blackketter/oc1/README

This directory contains the hardware design and support documents for the OpenCalc OC1 calculator.
