blackketter/oc1/pa1/docs/display/all-shore/ASIJ24016HFDCIDI.PDF

## Outline Drawing

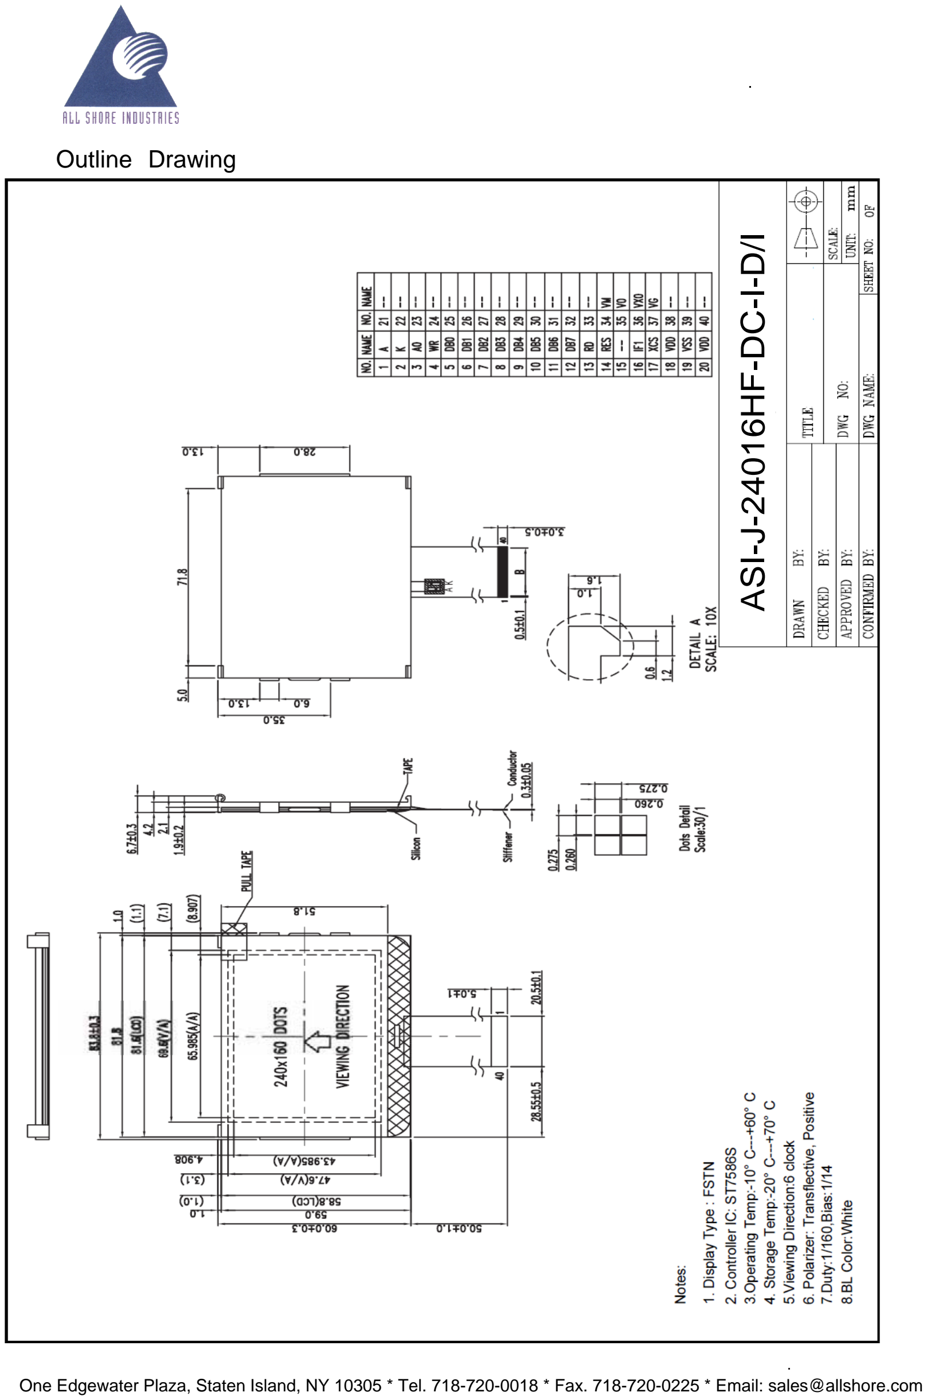
[picture p3: page 1]

One Edgewater Plaza, Staten Island, NY 10305 * Tel. 718-720-0018 * Fax. 718-720-0225 * Email: sales@allshore.com ASI-J⁻24016HF⁻DC⁻I-D/I
