blackketter/oc1/pa1/docs/display/all-shore/allshore-external-connections.jpg

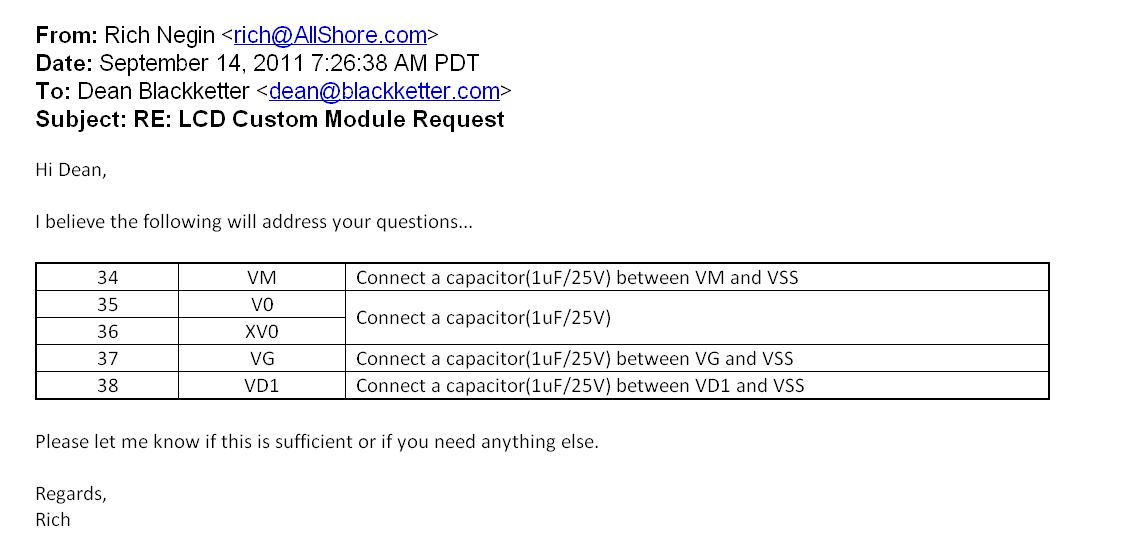
pa1/docs/display/all-shore/allshore-external-connections.jpg
