blackketter/oc1/datasheets/cpu/IMX23_POWER_CONSUMP_CALC.xls

Sheet: POWER CONSUMPTION CALCULATOR
 |  | i.MX23 Power Consumption Calculator
Disclaimer: The power consumption calculator is intended to provide an estimation of typical system power under different CPU clock frequencies and device configurations. The core power measurements were taken using 100% CPU load with the iMX23 power savings features disabled (i.e., INTERRUPT WAIT and HBUS AUTOSLOW). Actual measured power results may vary based on the actual application CPU loading.
INSTRUCTIONS
Enter configuration options into yellow cells. Select "INCLUDE" or "EXCLUDE" to include/exclude each power in the summary. |  |  |  |  |  | LEGEND | User Configurable Cells
Note that some power is Internal (on-chip) and some is External (off-chip) - consult legend to the right for color-coding. |  |  |  |  |  |  | Internal (On-chip) Power
The number in parenthesis following the power (e.g., (1) or (8)) corresponds to the system diagram (scroll to the bottom to see diagram). |  |  |  |  |  |  | External (Off-chip) Power
ARM CORE & DRAM | CONFIGURATION |  | VALUE | UNITS | COMMENTS
 | DRAM Type |  | DDR1 |  |  |  |  | Package | ThetaJA |  |  | Power Source | Speaker Impedance | Max. Pd |  |  |  | Temperature | Max. Tj |  | DRAM
 | CPU CLK / AHB CLK / EMI CLK Frequencies |  | 64.00 / 64.00 / 48.00 | MHz |  |  |  | 169BGA | 42 |  | EXCLUDE | VDD5V | 4 | 0 | Pink Noise |  |  | Industrial | 105 |  | DDR1
 | INCLUDE | i.MX23 ARM Core Power (4) | 34.75 | mW | On-chip power into iMX23 VDDD input with INTERRUPT WAIT and HBUS AUTOSLOW disabled. |  |  | 128QFP | 43 |  | INCLUDE | Li-Ion Battery | 8 | 1 | 1kHz 0dB Sine Wave |  |  | Commercial | 85 |  | mDDR
 | INCLUDE | i.MX23 DRAM Controller Power (2) | 9.925 | mW | On-chip power into iMX23 DDR1 Controller VDDIO_EMI input |  |  |  |  |  |  |  |  | 0.8
 | EXCLUDE | External DRAM Power (9) | 0.00 | mW | Off-chip power from VDDM supply into DDR1 DRAM |  |  | DDRLIST | 34.43 | 4.89 | 21.10 |  |  |  |  |  | 34.7516 | 9.9255 | 77.6225
HEADPHONE AMP | CONFIGURATION |  | VALUE | UNITS | COMMENTS |  |  | mDDR | PDDD | PDDA | PDDR1 | CPUCLK | HCLK | EMICLK | MENU | DDR1 | PDDD | PDDM | PDDR1 | CPUCLK | HCLK | EMICLK | MENU
 | Headphone Load |  | 32 | Ω |  |  |  |  | 16.10 | 0.89 | 5.32 | 24.00 | 24.00 | 24.00 | 24.00 / 24.00 / 24.00 |  | 34.75 | 9.93 | 77.62 | 64.00 | 64.00 | 48.00 | 64.00 / 64.00 / 48.00
 | Headphone Mode |  | Direct Drive |  |  |  |  |  | 34.43 | 4.89 | 21.10 | 64.00 | 64.00 | 48.00 | 64.00 / 64.00 / 48.00 |  | 125.26 | 18.83 | 75.84 | 261.82 | 130.91 | 130.91 | 261.82 / 130.91 / 130.91
 | File Type |  | Pink Noise |  | "Pink Noise" approximates real music. "1kHz 0dB Sine Wave" is likely worst-case. |  |  |  | 124.58 | 9.58 | 28.03 | 261.82 | 130.91 | 130.91 | 261.82 / 130.91 / 130.91 |  | 169.72 | 20.14 | 82.88 | 360.00 | 120.00 | 120.00 | 360.00 / 120.00 / 120.00
 | Output Amplitude |  | 0.113 | Vavg |  |  |  |  | 168.52 | 10.65 | 31.42 | 360.00 | 120.00 | 120.00 | 360.00 / 120.00 / 120.00 |  | 205.95 | 21.93 | 83.89 | 392.73 | 130.91 | 130.91 | 392.73 / 130.91 / 130.91
 | EXCLUDE | i.MX23 Headphone Amplifier Power (3) | 0.00 | mW | On-chip power into i.MX23 VDDA input due to headphone amp. Includes power into headphone load. |  |  |  | 205.06 | 11.18 | 31.95 | 392.73 | 130.91 | 130.91 | 392.73 / 130.91 / 130.91 |  | 272.71 | 24.73 | 91.29 | 454.74 | 151.58 | 151.58 | 454.74 / 151.58 / 151.58
SPEAKER AMP | CONFIGURATION |  | VALUE | UNITS | COMMENTS |  |  |  | 272.92 | 12.57 | 33.744 | 454.74 | 151.58 | 151.58 | 454.74 / 151.58 / 151.58
 | Speaker Impedance |  | 8 | Ω |  |  |  |  | Select Valid Frequency
 | File Type |  | 1kHz 0dB Sine Wave |  | "Pink Noise" approximates real music. "1kHz 0dB Sine Wave" is likely worst-case.
 | Output Amplitude |  | 1.210 | Vrms
 | EXCLUDE | i.MX23 Speaker Amplifier Power (5) | 0.00 | mW | On-chip power into i.MX23 VDDS input due to speaker amp. Includes power into speaker load. |  |  | Mode | File | Load | AC321K | AC161K | AC32P | AC16P | D321K | D161K | D32P | D16P |  | S41K | S81K | S4P | S8P
DAC | CONFIGURATION |  | VALUE | UNITS | COMMENTS |  |  | AC-Coupled | Pink Noise | 16 | 0.594 | 0.566 | 0.255 | 0.236 | 0.608 | 0.566 | 0.294 | 0.288 |  | 2.700 | 3.200 | 1.300 | 1.390
 | EXCLUDE | i.MX23 DAC Power (3) | 0.00 | mW | On-chip power into i.MX23 VDDA input due to DAC. Should be included if Headphone or Speaker are on. |  |  | Direct Drive | 1kHz 0dB Sine Wave | 32 | 0.523 | 0.509 | 0.161 | 0.186 | 0.587 | 0.516 | 0.210 | 0.230 |  | 2.580 | 2.630 | 1.250 | 1.060
SD/MMC CARD | CONFIGURATION |  | VALUE | UNITS | COMMENTS |  |  |  |  |  | 0.410 | 0.452 | 0.113 | 0.133 | 0.467 | 0.460 | 0.150 | 0.205 |  | 2.300 | 2.540 | 1.060 | 0.888
 | EXCLUDE | External SD/MMC Card Power (7) | 0.00 | mW | Off-chip power from VDDIO supply into SD/MMC card. Enter power from SD/MMC card datasheet. |  |  |  |  |  | 0.325 | 0.410 | 0.077 | 0.105 | 0.353 | 0.339 | 0.099 | 0.166 |  | 2.050 | 2.160 | 0.660 | 0.560
LCD | CONFIGURATION |  | VALUE | UNITS | COMMENTS |  |  | HP Power | HPList |  | 0.255 | 0.339 | 0.032 | 0.064 | 0.247 | 0.283 | 0.070 | 0.118 |  | 1.830 | 1.710 | 0.533 | 0.350
 | EXCLUDE | i.MX23 LCD Controller Power (1) | 0.00 | mW | On-chip power into i.MX23 VDDIO input due to LCD controller. |  |  | #N/A | D32P |  | 0.205 | 0.283 | 0.018 | 0.040 | 0.212 | 0.233 | 0.050 | 0.077 |  | 1.540 | 1.530 | 0.333 | 0.231
 | EXCLUDE | External LCD Digital Power (6) | 0.00 | mW | Off-chip power from VDDIO supply into LCD module . Enter power from LCD datasheet. |  |  |  | Pick Output Amplitude |  | 0.141 | 0.226 |  | 0.010 | 0.166 | 0.177 | 0.026 | 0.032 |  | 1.300 | 1.210 | 0.225 | 0.089
 | EXCLUDE | External LCD Backlight Power (10) | 0.00 | mW | Off-chip power from Li-Battery supply into LCD backlight. Enter power from LCD datasheet. |  |  |  |  |  | 0.106 | 0.170 |  |  | 0.127 | 0.113 |  |  |  | 1.160 | 1.020 | 0.093 | 0.038
NAND FLASH | CONFIGURATION |  | VALUE | UNITS | COMMENTS |  |  |  |  |  | 0.071 | 0.113 |  |  | 0.071 | 0.078 |  |  |  | 1.030 | 0.811
 | EXCLUDE | External NAND Flash Power (8) | 0.00 | mW | Off-chip power from VDDIO supply into NAND flash. Enter power from NAND datasheet. |  |  |  |  |  | 0.025 | 0.078 |  |  | 0.055 | 0.062 |  |  |  | 0.615 | 0.644
 |  |  |  |  |  |  |  |  |  |  |  | 0.028 |  |  | 0.036 | 0.028 |  |  |  | 0.461 | 0.512
RESULTS |  |  |  |  |  |  |  | SP Power | SPList |  |  |  |  |  |  |  |  |  |  | 0.260 | 0.322
 |  |  |  |  |  |  |  | 579.6 | S81K |  |  |  |  |  |  |  |  |  |  | 0.207 | 0.171
SUMMARY OF POWER BY SUPPLY RAIL | POWER BY RAIL SUMMARY |  | VALUE | UNITS | COMMENTS |  |  |  |  |  |  |  |  |  |  |  |  |  |  | 0.118 | 0.129
 | VDDD Power | Internal | 34.752 | mW | Includes: ARM core |  |  |  |  |  |  |  |  |  |  |  |  |  |  | 0.068 | 0.066
 |  | External | 0.000 | mW |  |  |  |  |  |  |  |  |  |  |  |  |  |  |  | 0.032 | 0.017
 |  | Total (13) | 34.752 | mW
 | VDDIO Power | Internal | 0.000 | mW | Includes: LCD controller, NAND flash controller, SD/MMC controller
 |  | External | 0.000 | mW | Includes: LCD, NAND flash, SD/MMC card
 |  | VDDM Linear Regulator Power | 3.176 | mW | Power dissipated in internal VDDM linear regulator powered from VDDIO. Mostly external.
 |  | Total (15) | 3.176 | mW
 | VDDA Power | Internal | 0.000 | mW | Includes: headphone amp, DAC, mDDR Controller
 |  | External | 0.000 | mW | Includes: mDDR DRAM device |  |  |  |  |  |  |  |  |  |  | EFFICIENCY
 |  | Total (14) | 0.000 | mW |  |  |  |  |  |  |  |  |  |  |  | Vin (V)
 | VDDM Power | Internal | 9.925 | mW | Includes: DDR1 controller |  |  |  | Spreadsheet Value | Approximation |  |  |  |  | LABEL | PDDD | PDDIO | PDDA | DCDC Settings | 4.2 | 4 | 3.8 | 3.6 | 3.4
 |  | External | 0.000 | mW | Includes: DDR1 DRAM device |  |  | PDDD | 34.7516 | 53 |  |  |  |  | 5315688 | 53 | 156 | 88 | Normal Fets | 0.9155 | 0.9176 | 0.9140 | 0.9155 | 0.9179
 |  | Total (16) | 9.925 | mW |  |  |  | PDDA | 0 | 88 |  |  |  |  | 53630350 | 53 | 630 | 350 | Normal Fets | 0.7479 | 0.7392 | 0.7205 | 0.6969 | 0.6575
 | Li-Ion Battery Power | Internal | 0.000 | mW | Includes: speaker amp |  |  | PDDIO + PDDM | 13.10166 | 156 |  |  |  |  | 5363088 | 53 | 630 | 88 | Normal Fets | 0.8488 | 0.8446 | 0.8415 | 0.8253 | 0.8026
 |  | External | 0.000 | mW | Includes: LCD backlight boost converter |  |  |  |  |  |  |  |  |  | 53156350 | 53 | 156 | 350 | Normal Fets | 0.7909 | 0.7955 | 0.7876 | 0.7885 | 0.7731
 |  | Total (10) + (5) | 0.000 | mW |  |  |  | LABEL | 5315688 |  |  |  |  |  | 12815688 | 128 | 156 | 88 | Normal Fets | 0.8626 | 0.8663 | 0.8667 | 0.8648 | 0.8618
TOTAL POWER CONSUMPTION ESTIMATE SUMMARY | TOTAL POWER SUMMARY |  | VALUE | UNITS | COMMENTS |  |  | MATCH | 1 |  |  |  |  |  | 128630350 | 128 | 630 | 350 | Normal Fets | 0.7297 | 0.7265 | 0.7028 | 0.6774 | 0.6419
 | Power Out of PMU | Internal | 44.677 | mW | On-chip power consumption estimate. Doesn't account for DCDC efficiency |  |  | INDEX | 0.9161064574 |  |  |  |  |  | 12863088 | 128 | 630 | 88 | Normal Fets | 0.8091 | 0.8053 | 0.8057 | 0.7866 | 0.7630
 |  | External | 3.176 | mW | Off-chip power consumption estimate. Doesn't account for DCDC efficiency |  |  |  |  |  |  |  |  |  | 128156350 | 128 | 156 | 350 | Normal Fets | 0.7743 | 0.7601 | 0.7612 | 0.7566 | 0.7691
 |  | Total (13) + (14) + (15) + (16) | 47.853 | mW | Total power consumption estimate. Doesn't account for DCDC efficiency |  |  |  |  |  |  |  |  |  | 23315688 | 233 | 156 | 88 | Double FETs | 0.8554 | 0.8554 | 0.8595 | 0.8520 | 0.8502
 | DCDC Efficiency |  | 91.61 | % | Estimate from DCDC Efficiency Curves |  |  |  |  |  |  |  |  |  | 233630350 | 233 | 630 | 350 | Double FETs | 0.7169 | 0.7064 | 0.7034 | 0.6807 | 0.6500
 | Battery Power Into PMU | Internal | 48.768 | mW | On-chip battery power consumption estimate, including DCDC efficiency |  |  |  |  |  |  |  |  |  | 23363088 | 233 | 630 | 88 | Double FETs | 0.8004 | 0.7934 | 0.7885 | 0.7813 | 0.7567
 |  | External | 3.467 | mW | Off-chip battery power consumption estimate, including DCDC efficiency |  |  |  |  |  |  |  |  |  | 233156350 | 233 | 156 | 350 | Double FETs | 0.7215 | 0.7183 | 0.7163 | 0.7112 | 0.7086
 |  | Total (11) | 52.235 | mW | Estimate of total battery power into PMU, including DCDC efficiency. Excludes battery power into non-PMU loads (e.g, speaker amp, LCD backlight).
 | Total Power Out Of Battery | Total (12) | 52.235 | mW | Estimate of total battery power consumption. Includes DCDC efficiency, speaker amp, and LCD backlight.

Sheet: Headphone Power
Headphone Mode | File Type | Headphone Load (Ω) | VDDA (V) | IddHP (mA) | Pin (mW) | Vout (Vrms) | Pout (mW) | Efficiency | DAC Power
Direct Drive | 1kHz 0dB Sine Wave | 16 | 1.85 | 70.0 | 126.75 | 0.566 | 39.99 | 31.55% | 2.7492
Direct Drive | 1kHz 0dB Sine Wave | 16 | 1.84 | 63.5 | 114.04 | 0.516 | 33.30 | 29.20% | Subtracted out from Pin
AC-Coupled | 1kHz 0dB Sine Wave | 16 | 1.81 | 39.7 | 69.11 | 0.566 | 39.99 | 57.86%
Direct Drive | 1kHz 0dB Sine Wave | 16 | 1.83 | 56.4 | 100.41 | 0.460 | 26.40 | 26.29%
AC-Coupled | 1kHz 0dB Sine Wave | 16 | 1.8 | 33.3 | 57.24 | 0.509 | 32.39 | 56.58%
AC-Coupled | 1kHz 0dB Sine Wave | 16 | 1.79 | 29.8 | 50.50 | 0.452 | 25.59 | 50.67%
Direct Drive | 1kHz 0dB Sine Wave | 16 | 1.8 | 43.5 | 75.50 | 0.339 | 14.40 | 19.07%
AC-Coupled | 1kHz 0dB Sine Wave | 16 | 1.79 | 27.0 | 45.58 | 0.410 | 21.02 | 46.11%
Direct Drive | 1kHz 0dB Sine Wave | 16 | 1.79 | 35.1 | 60.10 | 0.283 | 10.00 | 16.63%
AC-Coupled | 1kHz 0dB Sine Wave | 16 | 1.78 | 23.2 | 38.55 | 0.339 | 14.40 | 37.35%
Direct Drive | 1kHz 0dB Sine Wave | 16 | 1.78 | 28.4 | 47.80 | 0.233 | 6.80 | 14.23%
AC-Coupled | 1kHz 0dB Sine Wave | 16 | 1.77 | 19.0 | 30.88 | 0.283 | 10.00 | 32.37%
Direct Drive | 1kHz 0dB Sine Wave | 16 | 1.77 | 21.0 | 34.42 | 0.177 | 3.91 | 11.35%
Direct Drive | 1kHz 0dB Sine Wave | 16 | 1.76 | 15.1 | 23.76 | 0.113 | 1.60 | 6.73%
AC-Coupled | 1kHz 0dB Sine Wave | 16 | 1.77 | 15.6 | 24.77 | 0.226 | 6.40 | 25.83%
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
AC-Coupled | 1kHz 0dB Sine Wave | 32 | 1.74 | 3.0 | 2.47 | 0.025 | 0.04 | 1.64%
Direct Drive | Pink Noise | 32 | 1.74 | 4.5 | 5.08 | 0.026 | 0.04 | 0.83%
AC-Coupled | Pink Noise | 32 | 1.74 | 3.2 | 2.84 | 0.018 | 0.02 | 0.71%

Sheet: Speaker Power
File Type | Speaker Load (Ω) | VDDS | IDDS (mA) | Pin (mW) | Vout (Vrms) | Pout (mW) | Efficiency | Pdiss On chip (mW)
1kHz 0dB Sine Wave | 4 | 4.2 | 659 | 2767.8 | 2.700 | 1638.20 | 59.19% | 1129.6
1kHz 0dB Sine Wave | 4 | 4.2 | 608 | 2553.6 | 2.580 | 1495.82 | 58.58% | 1057.8
1kHz 0dB Sine Wave | 4 | 4.2 | 523 | 2196.6 | 2.300 | 1188.76 | 54.12% | 1007.8
1kHz 0dB Sine Wave | 4 | 4.2 | 464 | 1948.8 | 2.050 | 944.38 | 48.46% | 1004.4
1kHz 0dB Sine Wave | 4 | 4.2 | 414 | 1738.8 | 1.830 | 752.56 | 43.28% | 986.2
1kHz 0dB Sine Wave | 4 | 4.2 | 348 | 1461.6 | 1.540 | 532.94 | 36.46% | 928.7
1kHz 0dB Sine Wave | 4 | 4.2 | 293 | 1230.6 | 1.300 | 379.78 | 30.86% | 850.8
1kHz 0dB Sine Wave | 4 | 4.2 | 261 | 1096.2 | 1.160 | 302.38 | 27.58% | 793.8
Pink Noise | 4 | 4.2 | 202 | 848.4 | 0.660 | 96.80 | 11.41% | 751.6
1kHz 0dB Sine Wave | 4 | 4.2 | 233 | 978.6 | 1.030 | 238.40 | 24.36% | 740.2
Pink Noise | 4 | 4.2 | 265 | 1113 | 1.300 | 375.56 | 33.74% | 737.4
Pink Noise | 4 | 4.2 | 247 | 1037.4 | 1.250 | 347.22 | 33.47% | 690.2
Pink Noise | 4 | 4.2 | 212 | 890.4 | 1.060 | 249.69 | 28.04% | 640.7
1kHz 0dB Sine Wave | 4 | 4.2 | 139 | 583.8 | 0.615 | 84.99 | 14.56% | 498.8
1kHz 0dB Sine Wave | 8 | 4.2 | 195 | 819.0 | 1.710 | 365.51 | 44.63% | 453.5
1kHz 0dB Sine Wave | 8 | 4.2 | 245 | 1029.0 | 2.160 | 583.20 | 56.68% | 445.8
1kHz 0dB Sine Wave | 8 | 4.2 | 174 | 730.8 | 1.530 | 292.61 | 40.04% | 438.2
1kHz 0dB Sine Wave | 8 | 4.2 | 288 | 1209.6 | 2.540 | 806.45 | 66.67% | 403.2
1kHz 0dB Sine Wave | 8 | 4.2 | 138 | 579.6 | 1.210 | 183.01 | 31.58% | 396.6
1kHz 0dB Sine Wave | 8 | 4.2 | 300 | 1260.0 | 2.630 | 864.61 | 68.62% | 395.4
1kHz 0dB Sine Wave | 4 | 4.2 | 104 | 436.8 | 0.461 | 47.76 | 10.93% | 389.0
Pink Noise | 4 | 4.2 | 106 | 445.2 | 0.533 | 63.13 | 14.18% | 382.1
1kHz 0dB Sine Wave | 8 | 4.2 | 116 | 487.2 | 1.020 | 130.05 | 26.69% | 357.2
Pink Noise | 8 | 4.2 | 140 | 588.0 | 1.390 | 241.51 | 41.07% | 346.5
Pink Noise | 8 | 4.2 | 115 | 483.0 | 1.060 | 140.45 | 29.08% | 342.5
1kHz 0dB Sine Wave | 8 | 4.2 | 386 | 1621.2 | 3.200 | 1280.00 | 78.95% | 341.2
1kHz 0dB Sine Wave | 8 | 4.2 | 92 | 386.4 | 0.811 | 82.22 | 21.28% | 304.2
Pink Noise | 8 | 4.2 | 90 | 378.0 | 0.888 | 98.57 | 26.08% | 279.4
1kHz 0dB Sine Wave | 8 | 4.2 | 73 | 306.6 | 0.644 | 51.84 | 16.91% | 254.8
Pink Noise | 4 | 4.2 | 66 | 277.2 | 0.333 | 24.64 | 8.89% | 252.6
1kHz 0dB Sine Wave | 4 | 4.2 | 59 | 247.8 | 0.260 | 15.19 | 6.13% | 232.6
1kHz 0dB Sine Wave | 8 | 4.2 | 58 | 243.6 | 0.512 | 32.77 | 13.45% | 210.8
Pink Noise | 8 | 4.2 | 55 | 231.0 | 0.560 | 39.20 | 16.97% | 191.8
1kHz 0dB Sine Wave | 4 | 4.2 | 47 | 197.4 | 0.207 | 9.63 | 4.88% | 187.8
Pink Noise | 4 | 4.2 | 45 | 189 | 0.225 | 11.25 | 5.95% | 177.8
Pink Noise | 8 | 4.2 | 38 | 159.6 | 0.350 | 15.31 | 9.59% | 144.3
1kHz 0dB Sine Wave | 8 | 4.2 | 37 | 155.4 | 0.322 | 12.96 | 8.34% | 142.4
1kHz 0dB Sine Wave | 4 | 4.2 | 27 | 113.4 | 0.118 | 3.13 | 2.76% | 110.3
Pink Noise | 8 | 4.2 | 23 | 96.6 | 0.231 | 6.67 | 6.90% | 89.9
1kHz 0dB Sine Wave | 8 | 4.2 | 20 | 84.0 | 0.171 | 3.66 | 4.35% | 80.3
Pink Noise | 4 | 4.2 | 18.5 | 77.7 | 0.093 | 1.92 | 2.47% | 75.8
1kHz 0dB Sine Wave | 4 | 4.2 | 15 | 63 | 0.068 | 1.04 | 1.65% | 62.0
1kHz 0dB Sine Wave | 8 | 4.2 | 15 | 63.0 | 0.129 | 2.08 | 3.30% | 60.9
Pink Noise | 8 | 4.2 | 9 | 37.8 | 0.089 | 0.99 | 2.62% | 36.8
1kHz 0dB Sine Wave | 8 | 4.2 | 7.9 | 33.2 | 0.066 | 0.54 | 1.64% | 32.6
1kHz 0dB Sine Wave | 4 | 4.2 | 7 | 29.4 | 0.032 | 0.23 | 0.78% | 29.2
Pink Noise | 8 | 4.2 | 4.5 | 18.9 | 0.038 | 0.18 | 0.96% | 18.7
1kHz 0dB Sine Wave | 8 | 4.2 | 2.4 | 10.1 | 0.017 | 0.04 | 0.36% | 10.0

Sheet: Power Options
FEATURE COMPARISON | VDD5V | DCDC_BATT | Comments
Operating Input Voltage Minimum | 4.40V | 2.6V | For both power options, the maximum supply output current will be reduced as the Input Voltage minimum is approached.
Operating Input Voltage Maximum | 5.25V | 4.242V
Power Consumption Minimum with output supply rails active | ~12.5mW | ~4.2mW | Excludes DRAM power?
Ability to power down completely without disconnecting power supply? | NO | YES | The output supply rails (VDDIO, VDDA, VDDD) will always be powered if VDD5V is powered.
On-Chip Power Dissipation | HIGHER | LOWER
Efficiency | LOWER | HIGHER

Sheet: DCDC Efficiency
 |  |  |  |  | EFFICIENCY
 |  |  |  |  | BATTERY (V)
PDDD (mW) | PDDIO (mW | PDDA (mW) | TOTAL POWER (mW) | DCDC Settings | 4.2 | 4 | 3.8 | 3.6 | 3.4 | 3.2 | AVERAGE (4.2 - 3.4) | NAME
52.5 | 156 | 88 | 323 | Normal FETs | 91.55% | 91.76% | 91.40% | 91.55% | 91.79% | 91.35% | 91.61% | PDDD=52.5mW,PDDIO=156mW,PDDA=88mW,DCDC Mode=Normal FETs
52.5 | 670.8 | 359.04 | 1108.84 | Normal FETs | 74.79% | 73.92% | 72.05% | 69.69% | 65.75% | 58.73% | 71.24% | PDDD=52.5mW,PDDIO=670.8mW,PDDA=359.04mW,DCDC Mode=Normal FETs
52.5 | 670.8 | 88 | 837.8 | Normal FETs | 84.88% | 84.46% | 84.15% | 82.53% | 80.26% | 76.11% | 83.26% | PDDD=52.5mW,PDDIO=670.8mW,PDDA=88mW,DCDC Mode=Normal FETs
52.5 | 156 | 369.6 | 604.6 | Normal FETs | 79.09% | 79.55% | 78.76% | 78.85% | 77.31% | 77.12% | 78.71% | PDDD=52.5mW,PDDIO=156mW,PDDA=369.6mW,DCDC Mode=Normal FETs
128 | 156 | 88 | 398.5 | Normal FETs | 86.26% | 86.63% | 86.67% | 86.48% | 86.18% | 85.30% | 86.44% | PDDD=128mW,PDDIO=156mW,PDDA=88mW,DCDC Mode=Normal FETs
128 | 624 | 343.2 | 1121.7 | Normal FETs | 72.97% | 72.65% | 70.28% | 67.74% | 64.19% | 57.46% | 69.56% | PDDD=128mW,PDDIO=624mW,PDDA=343.2mW,DCDC Mode=Normal FETs
128 | 624 | 88 | 866.5 | Normal FETs | 80.91% | 80.53% | 80.57% | 78.66% | 76.30% | 72.99% | 79.39% | PDDD=128mW,PDDIO=624mW,PDDA=88mW,DCDC Mode=Normal FETs
128 | 156 | 343.2 | 653.7 | Normal FETs | 77.43% | 76.01% | 76.12% | 75.66% | 76.91% | 74.28% | 76.43% | PDDD=128mW,PDDIO=156mW,PDDA=343.2mW,DCDC Mode=Normal FETs
232.5 | 156 | 88 | 503 | Double FETs | 85.54% | 85.54% | 85.95% | 85.20% | 85.02% | 84.51% | 85.45% | PDDD=232.5mW,PDDIO=156mW,PDDA=88mW,DCDC Mode=Double FETs
232.5 | 617.76 | 360.8 | 1237.56 | Double FETs | 71.69% | 70.64% | 70.34% | 68.07% | 65.00% | 59.04% | 69.15% | PDDD=232.5mW,PDDIO=617.76mW,PDDA=360.8mW,DCDC Mode=Double FETs
232.5 | 617.76 | 88 | 964.76 | Double FETs | 80.04% | 79.34% | 78.85% | 78.13% | 75.67% | 73.89% | 78.40% | PDDD=232.5mW,PDDIO=617.76mW,PDDA=88mW,DCDC Mode=Double FETs
232.5 | 156 | 360.8 | 775.8 | Double FETs | 72.15% | 71.83% | 71.63% | 71.12% | 70.86% | 70.27% | 71.52% | PDDD=232.5mW,PDDIO=156mW,PDDA=360.8mW,DCDC Mode=Double FETs

Sheet: Core & EMI Power
VDDD Power vs. CPU CLK Frequency, VDDIO.EMI Power vs. EMI CLK Frequency |  |  |  |  |  |  |  |  |  |  |  |  |  |  |  | Doesn't match datasheet
Setup: Running Dhrystone Power test, Interupt Wait Disabled, HBUS Autoslow = OFF
VDDD (V) | IDDD (mA) | PDDD (mW) | VDDIO.EMI (V) | IDDIO.EMI (mA) | PDDIO.EMI (mW) | VDDIO.DRAM (V) | IDDIO.DRAM (mA) | PDDIO.DRAM (mW) | PLL | HW_DIGCTRL ARMCACHE (note 1) | CPUCLK / clk_p Frequency (MHz) | HW_CLKCTRL CPU_DIV_CPU | HW_CLKCTRL FRAC_CPUFRC / PFD | AHBCLK / clk_h Frequency (MHz) | HW_CLKCTRL HBUS_DIV | EMICLK / clk_emi Frequency (MHz) | HW_CLKCTRL EMI_DIV_EMI | HW_CLKCTRL FRAC_EMIFRAC | SUPPORTED DRAM | Drystones/s
1.066 | 32.600 | 34.752 | 2.545 | 3.900 | 9.925 | 2.545 | 30.500 | 77.623 | ON | 11 | 64.00 | 5 | 27 | 64.00 | 1 | 48.00 | 6 | 30 | DDR | 66138
1.294 | 96.800 | 125.259 | 2.545 | 7.400 | 18.833 | 2.545 | 29.800 | 75.841 | ON | 00 | 261.82 | 1 | 33 | 130.91 | 2 | 130.91 | 2 | 33 | DDR | 274725
1.398 | 121.400 | 169.717 | 2.550 | 7.900 | 20.145 | 2.550 | 32.500 | 82.875 | ON | 00 | 360.00 | 1 | 24 | 120.00 | 3 | 120.00 | 3 | 24 | DDR | 377644
1.470 | 140.100 | 205.947 | 2.550 | 8.600 | 21.930 | 2.550 | 32.900 | 83.895 | ON | 00 | 392.73 | 1 | 22 | 130.91 | 3 | 130.91 | 2 | 33 | DDR | 412201
1.570 | 173.700 | 272.709 | 2.550 | 9.700 | 24.735 | 2.550 | 35.800 | 91.290 | ON | 00 | 454.74 | 1 | 19 | 151.58 | 3 | 151.58 | 3 | 19 | DDR
VDDD (V) | IDDD (mA) | PDDD (mW) | VDDIO.EMI (V) | IDDIO.EMI (mA) | PDDIO.EMI (mW) | VDDIO.DRAM (V) | IDDIO.DRAM (mA) | PDDIO.DRAM (mW) | PLL | HW_DIGCTRL ARMCACHE (note 1) | CPUCLK / clk_p Frequency (MHz) | HW_CLKCTRL CPU_DIV_CPU | HW_CLKCTRL FRAC_CPUFRC / PFD | AHBCLK / clk_h Frequency (MHz) | HW_CLKCTRL HBUS_DIV | EMICLK / clk_emi Frequency (MHz) | HW_CLKCTRL EMI_DIV_EMI | HW_CLKCTRL FRAC_EMIFRAC | SUPPORTED DRAM
1.066 | 15.100 | 16.097 | 1.773 | 0.500 | 0.886 | 1.773 | 3.000 | 5.319 | OFF |  | 24.00 |  |  | 24.00 |  | 24.00 |  |  | mDDR
1.066 | 32.300 | 34.432 | 1.773 | 2.760 | 4.893 | 1.773 | 11.900 | 21.099 | ON | 11 | 64.00 | 5 | 27 | 64.00 | 1 | 48.00 | 6 | 30 | mDDR
1.295 | 96.200 | 124.579 | 1.774 | 5.400 | 9.580 | 1.774 | 15.800 | 28.029 | ON | 00 | 261.82 | 1 | 33 | 130.91 | 2 | 130.91 | 2 | 33 | mDDR
1.395 | 120.800 | 168.516 | 1.775 | 6.000 | 10.650 | 1.775 | 17.700 | 31.417 | ON | 00 | 360.00 | 1 | 24 | 120.00 | 3 | 120.00 | 3 | 24 | mDDR
1.470 | 139.500 | 205.065 | 1.775 | 6.300 | 11.182 | 1.775 | 18.000 | 31.950 | ON | 00 | 392.73 | 1 | 22 | 130.91 | 3 | 130.91 | 2 | 33 | mDDR
1.573 | 173.500 | 272.916 | 1.776 | 7.080 | 12.574 | 1.776 | 19.000 | 33.744 | ON | 00 | 454.74 | 1 | 19 | 151.58 | 3 | 151.58 | 3 | 19 | mDDR
Vbat | 4.2
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
