blackketter/oc1/ID/oc1_concept_presentation_001.pdf

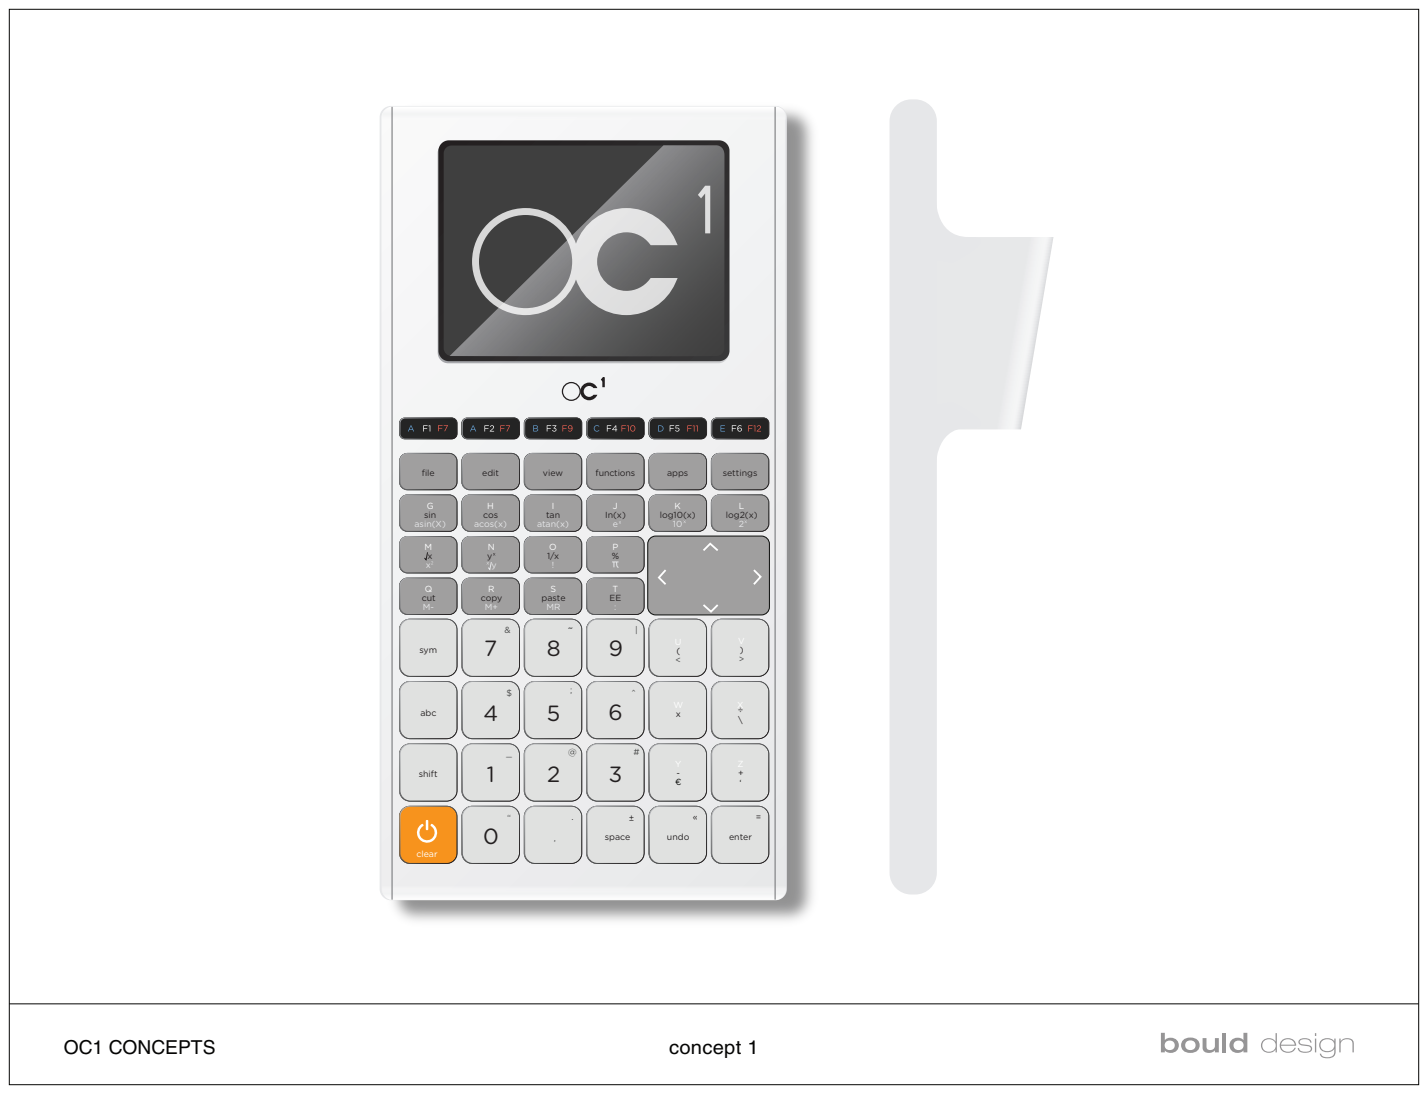
[picture p5: page 1]
OC1 CONCEPTS; concept 1; sym; abc; shift; undo; enter; space; sin; asin(X); cos; acos(x); tan; atan(x); log10(x); log2(x); copy; file; edit; view; functions; apps; settings; cut; paste; clear

# cmf exporation

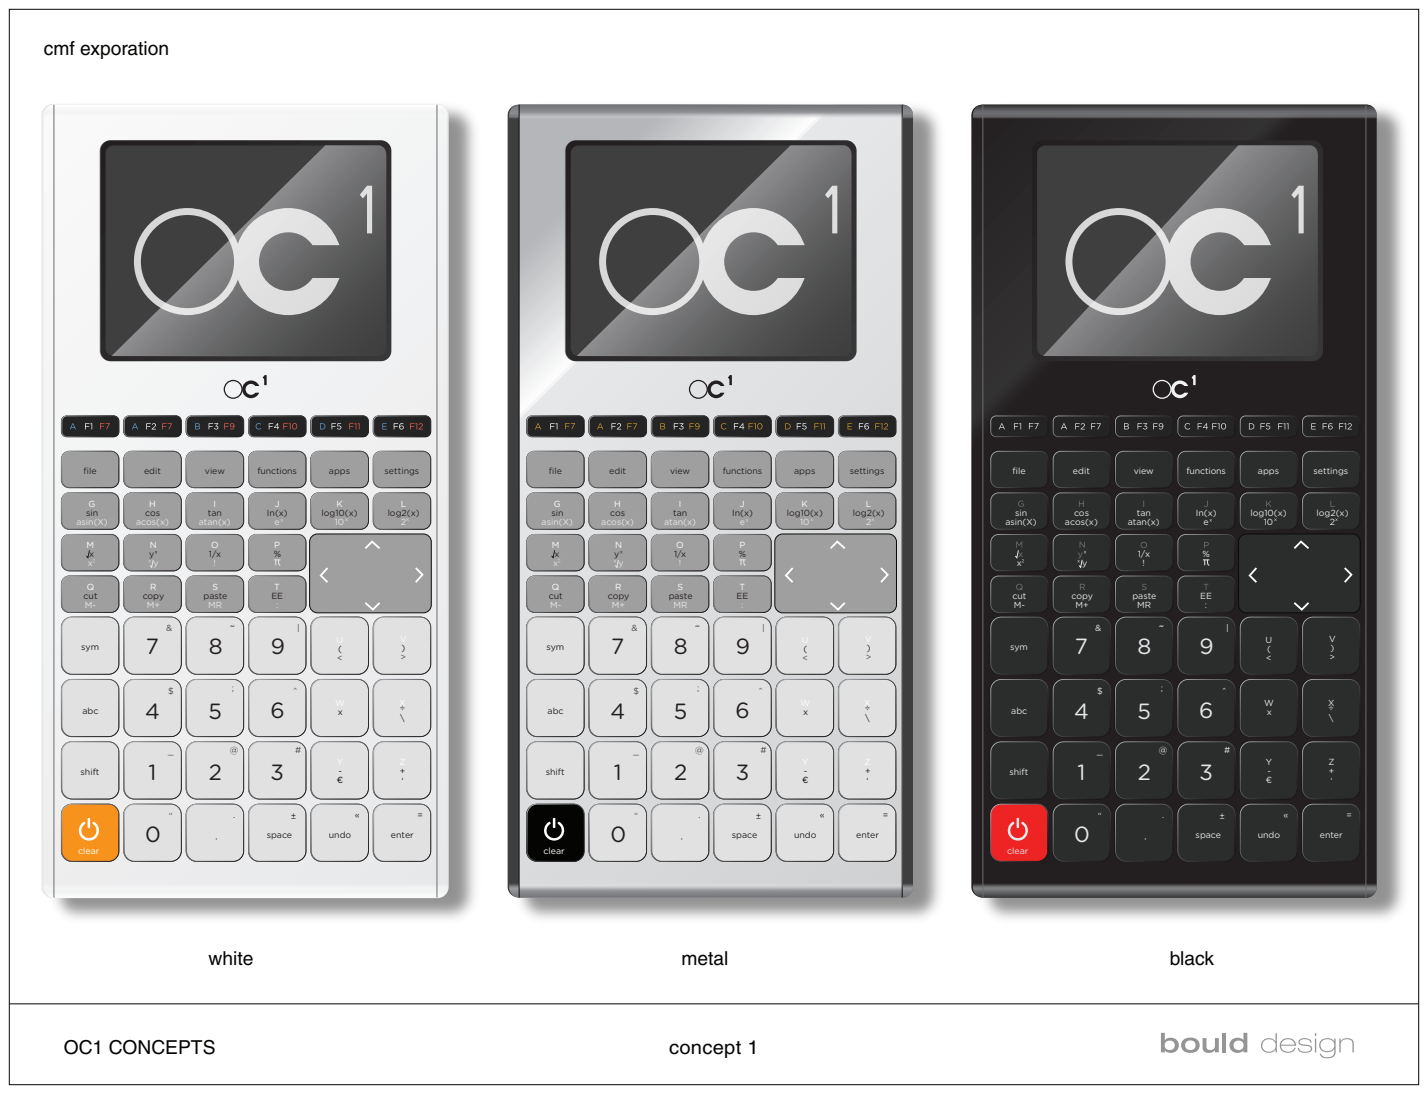
[picture p6: page 2]
OC1 CONCEPTS; white; metal; black; concept 1; sym; abc; shift; undo; enter; space; sin; asin(X); cos; acos(x); tan; atan(x); log10(x); log2(x); copy; file; edit; view; functions; apps; settings; cut; paste; clear; sin asin(X); cos acos(x); tan atan(x); log10(x) 10; log2(x) 2; copy M+; cut M-; paste MR

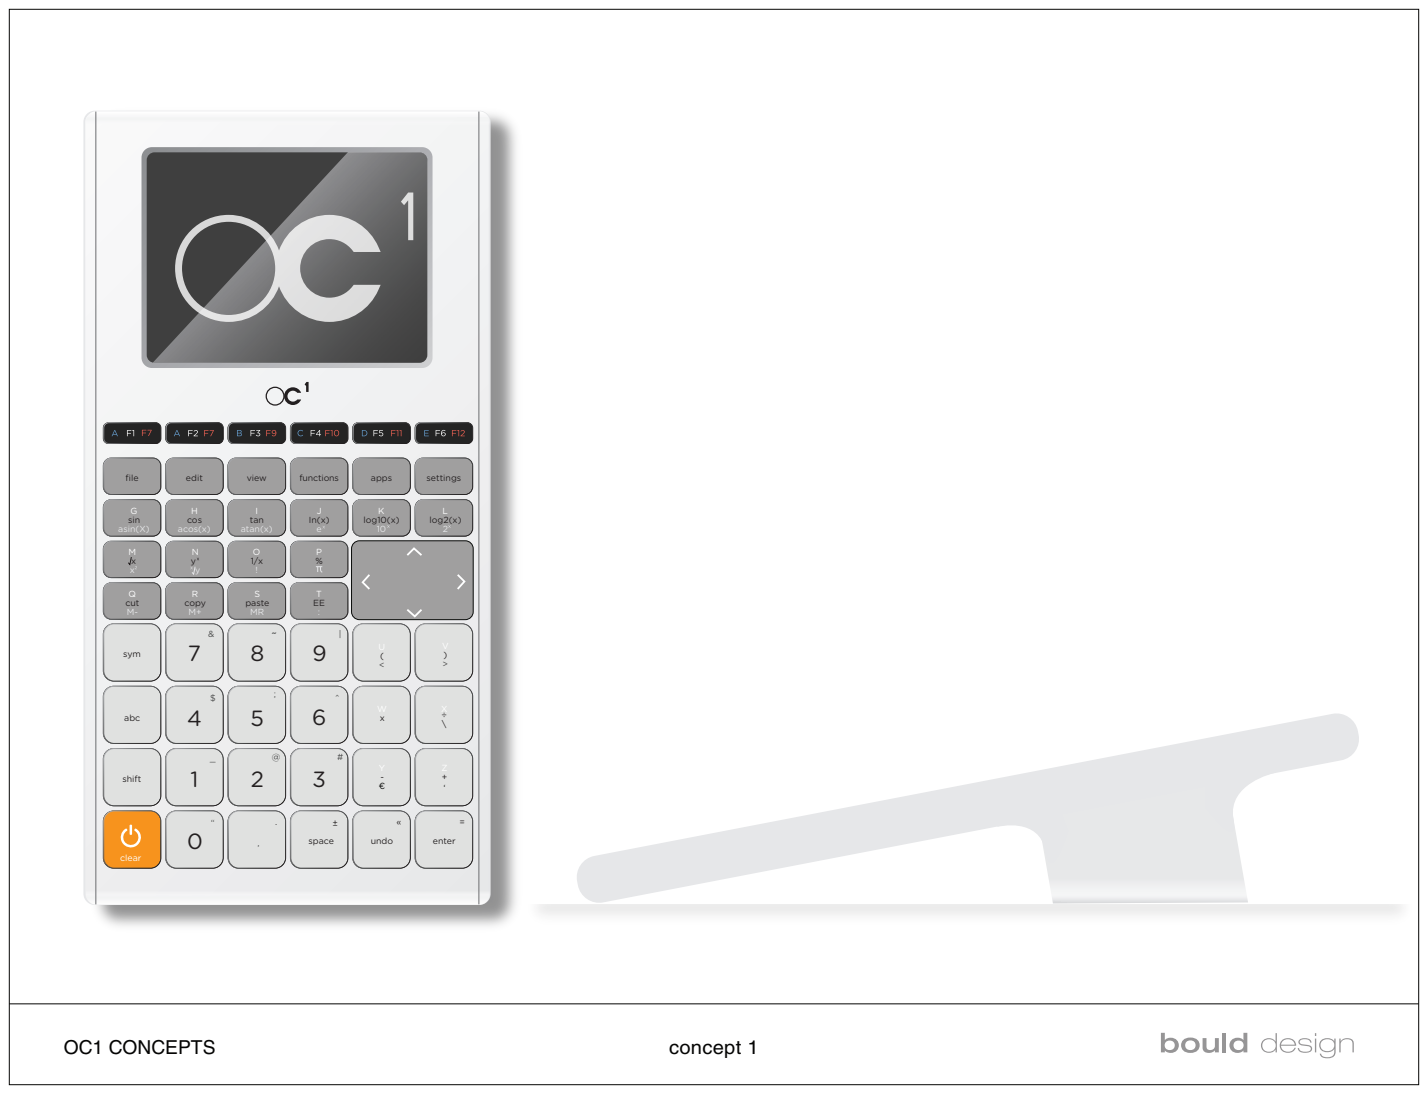
[picture p7: page 3]
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

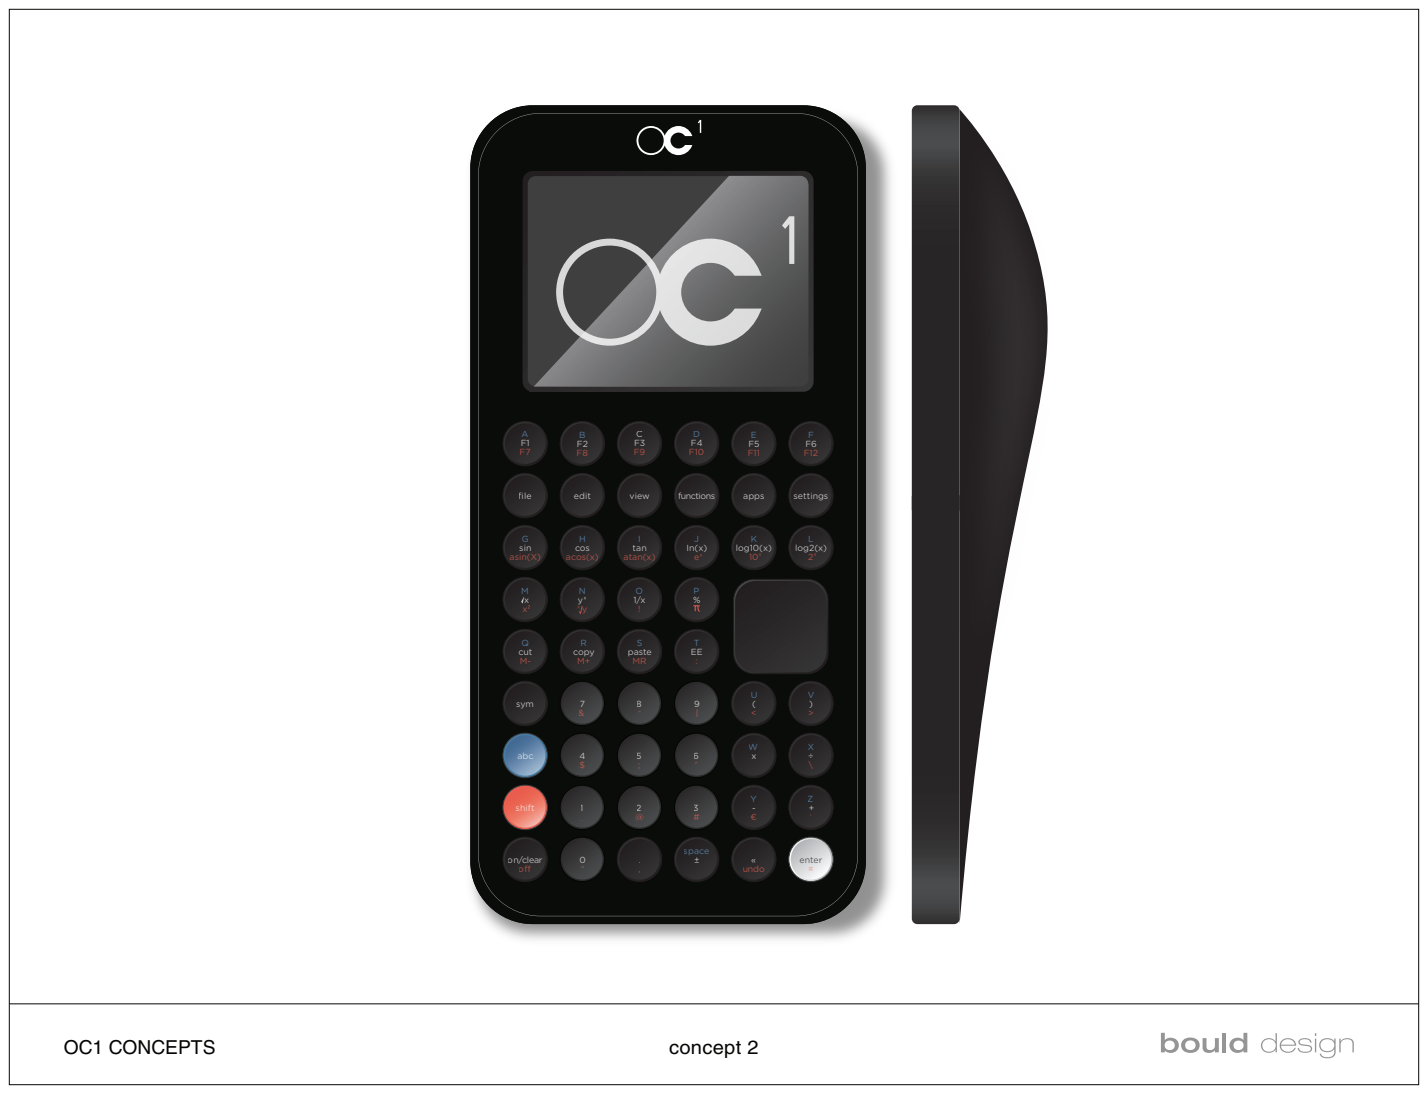
[picture p8: page 4]
file; edit; view; functions; apps; settings; sin; asin(X); cos; acos(x); tan; atan(x); log10(x); log2(x); cut; copy; paste; sym; abc; shift; on/clear o"; space; « undo; enter =

# cmf exporation

1

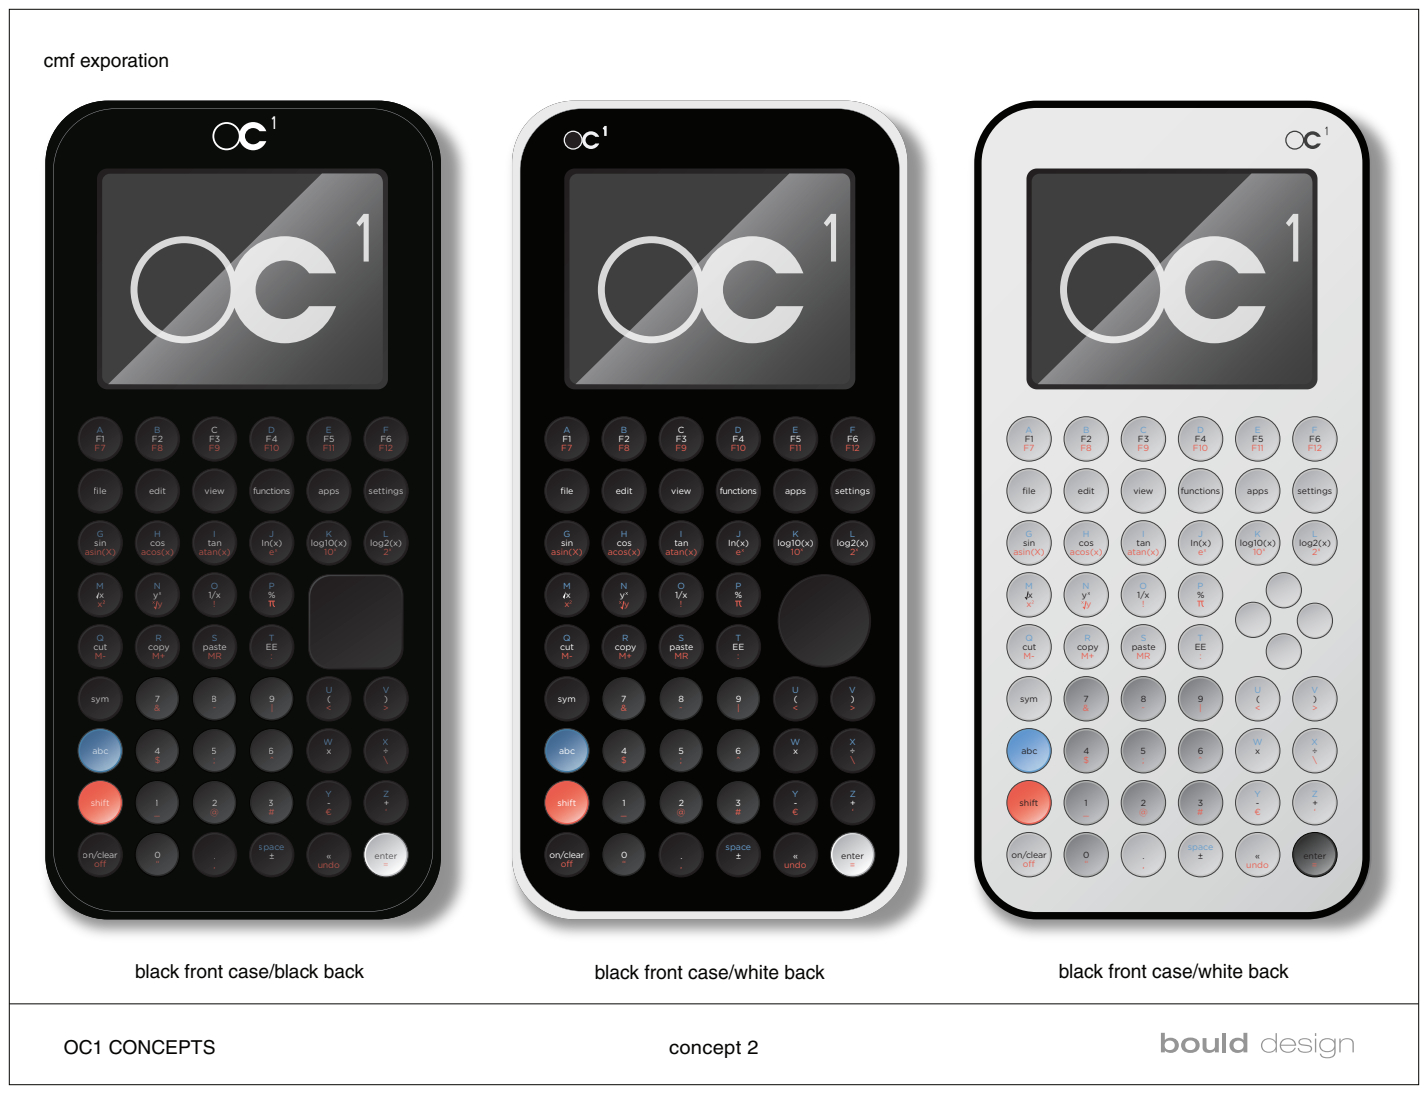
[picture p9: page 5]
black front case/black back; black front case/white back; file; edit; view; functions; apps; settings; sin; asin(X); cos; acos(x); tan; atan(x); log10(x); log2(x); cut; copy; paste; sym; abc; shift; on/clear o"; space; « undo; enter =

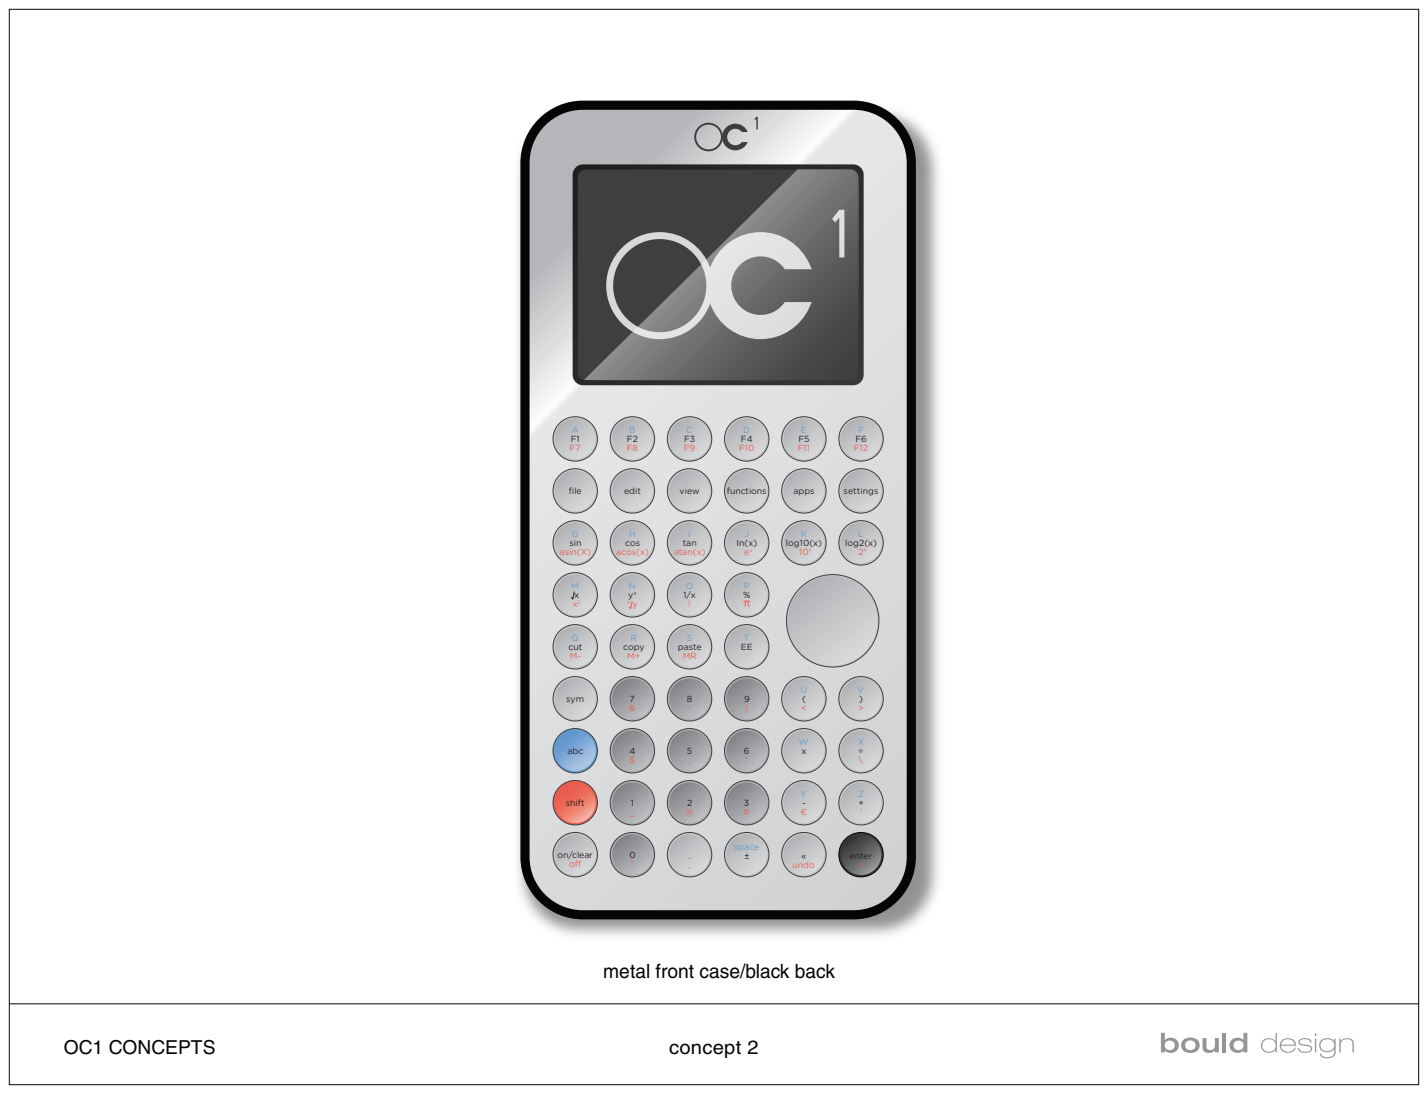
[picture p10: page 6]
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

metal front case/black back

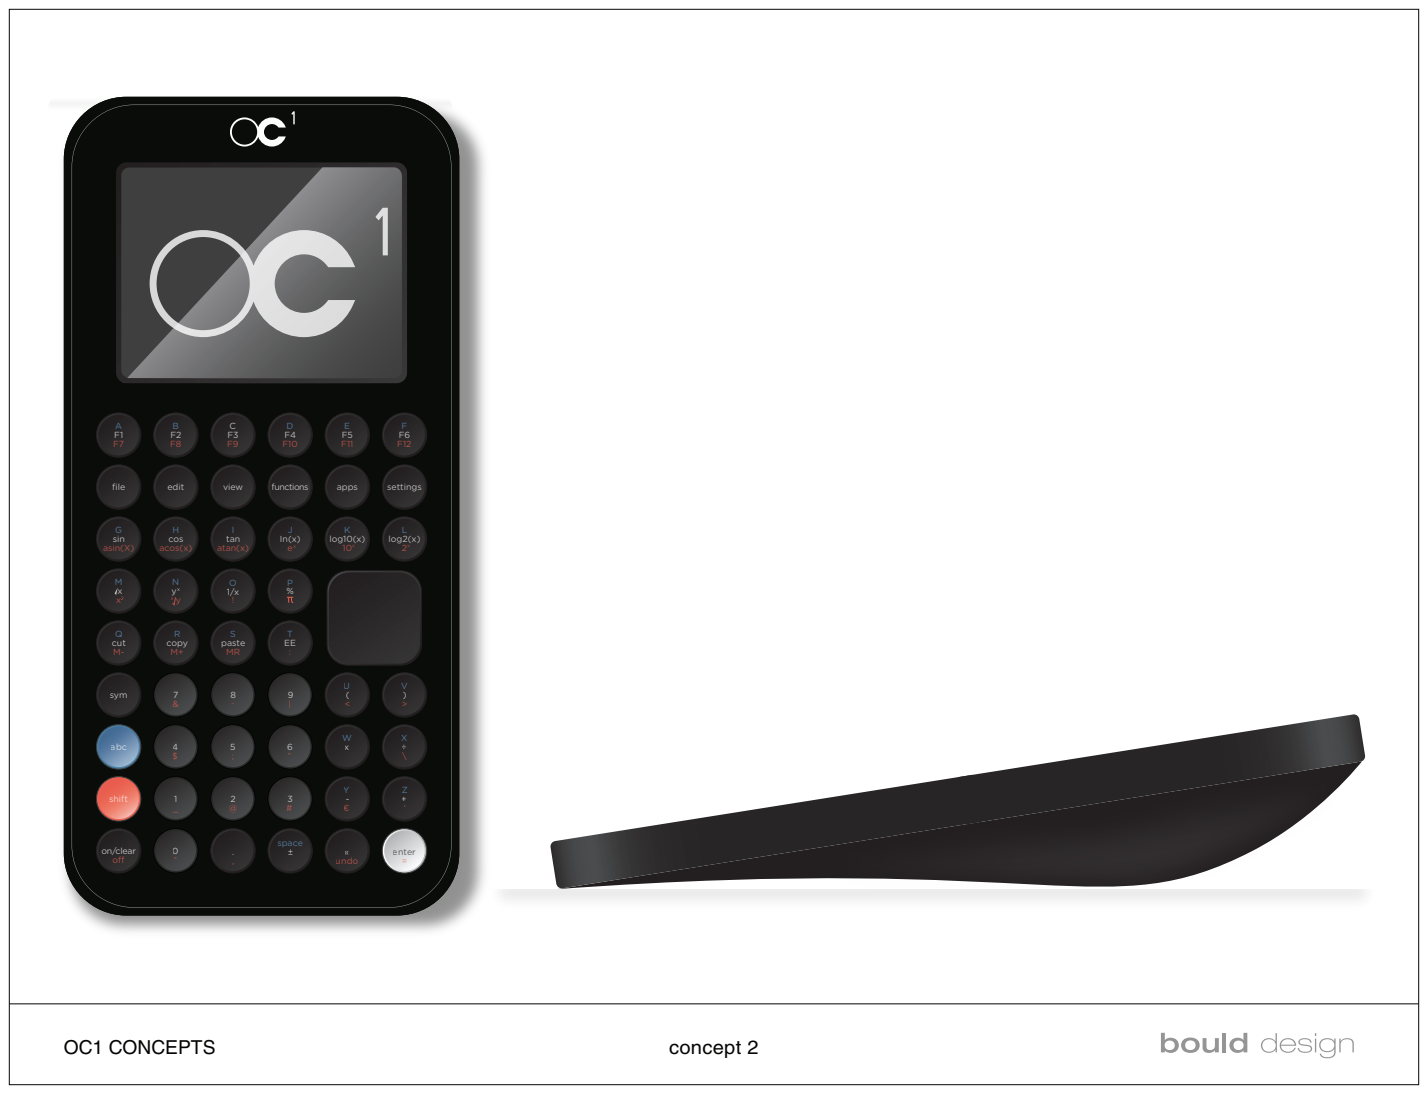
[picture p11: page 7]
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

concept 1 | concept 2

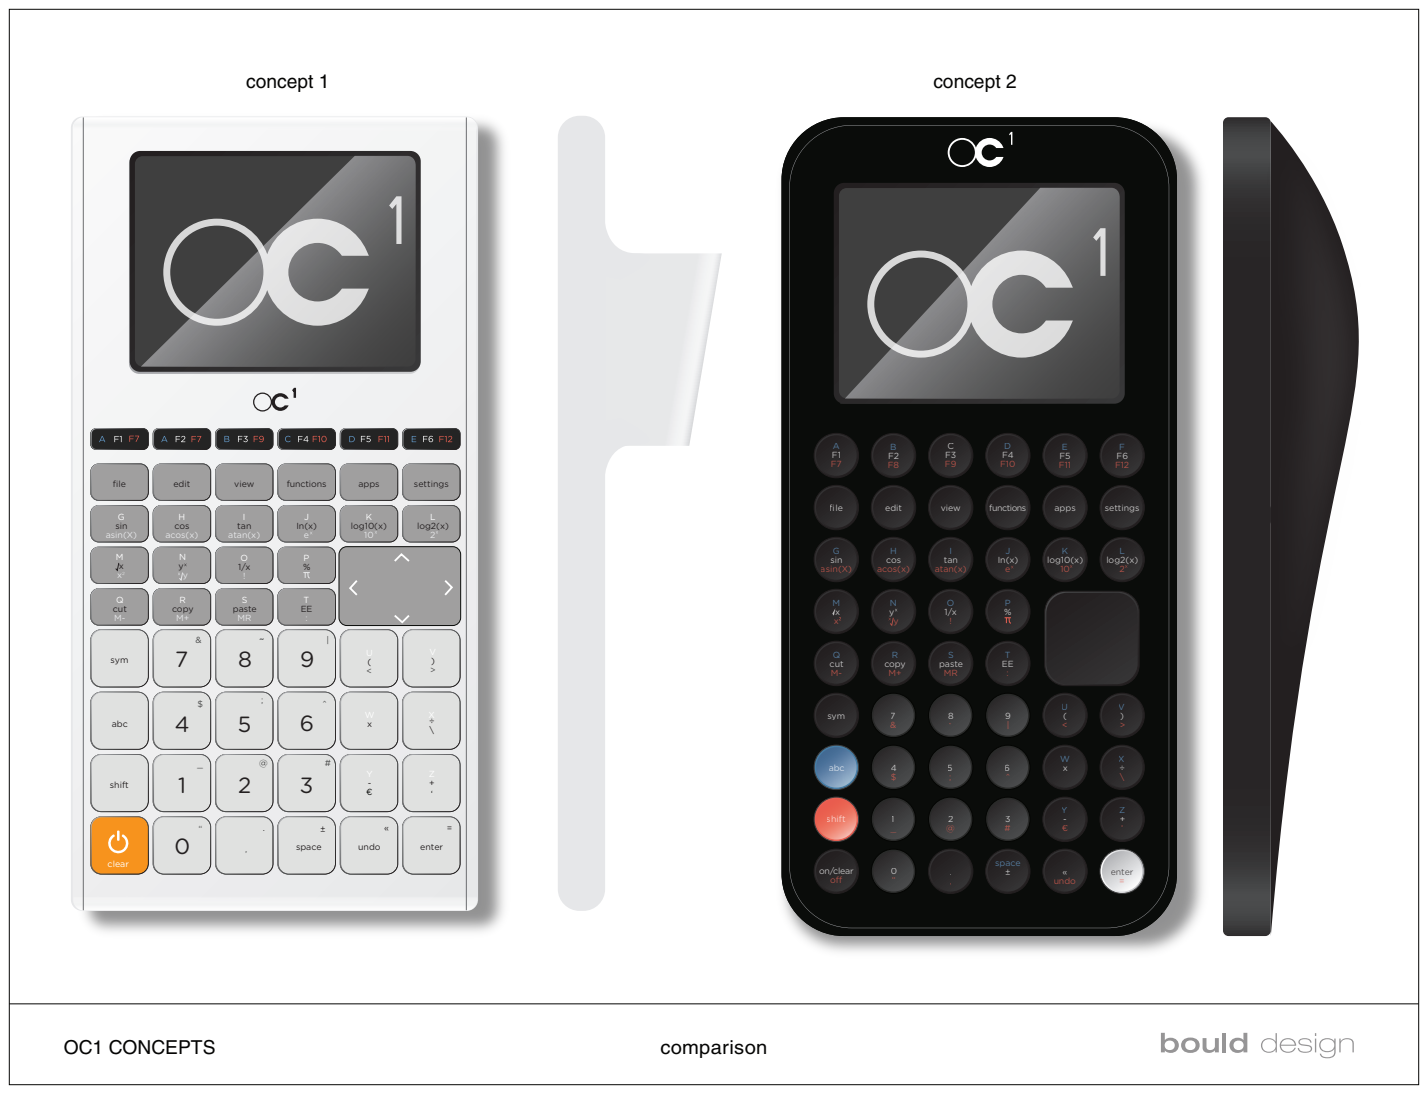
[picture p12: page 8]
OC1 CONCEPTS; comparison; file; edit; view; functions; apps; settings; sin; asin(X); cos; acos(x); tan; atan(x); log10(x); log2(x); cut; copy; paste; sym; abc; shift; on/clear o"; space; « undo; enter =; undo; enter; clear
