blackketter/oc1/pa1/sch/OPENCALC-PA1.pdf

5

4

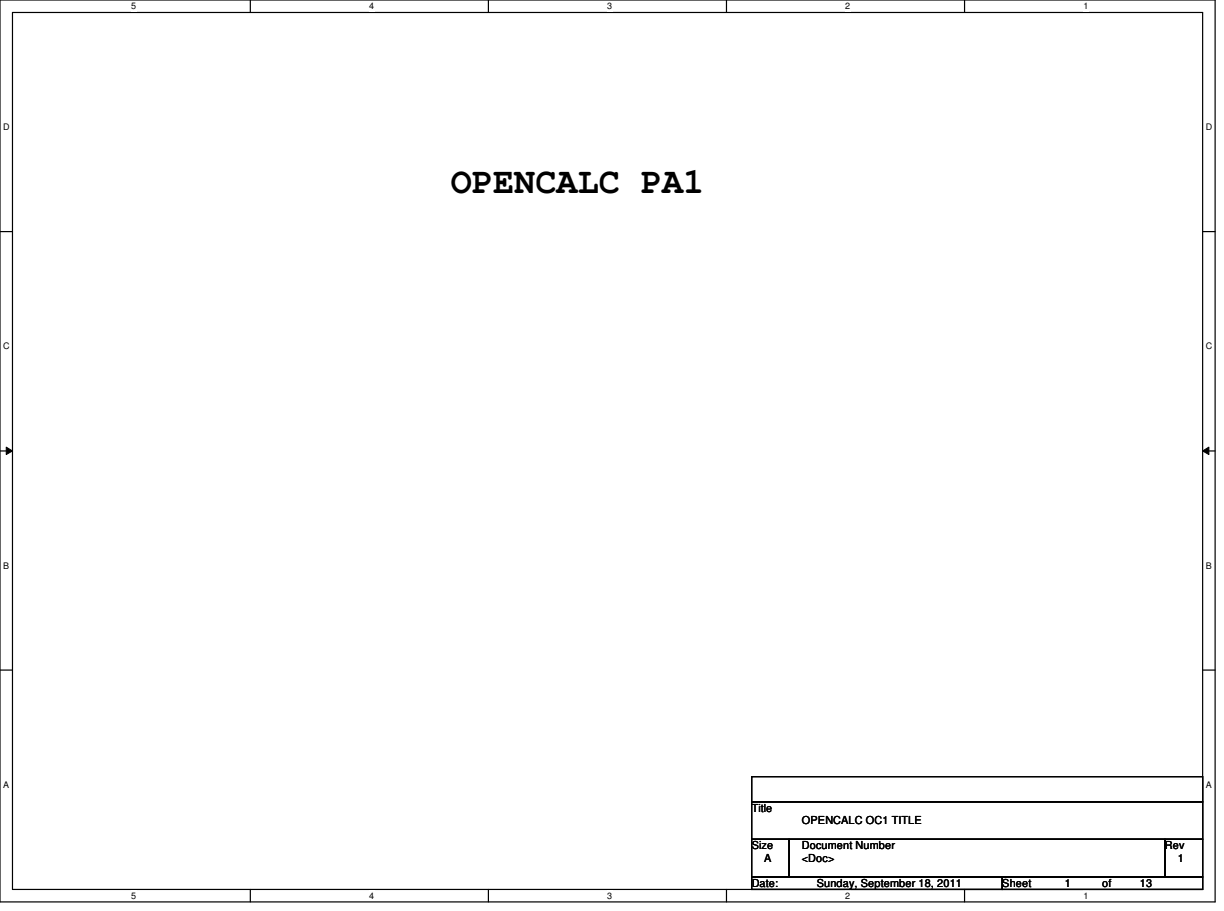
[picture p21: page 1]
Title; Size; Document Number; Rev; Date:; Sheet; <Doc>; OPENCALC OC1 TITLE; Sunday, September 18, 2011; OPENCALC PA1

C C

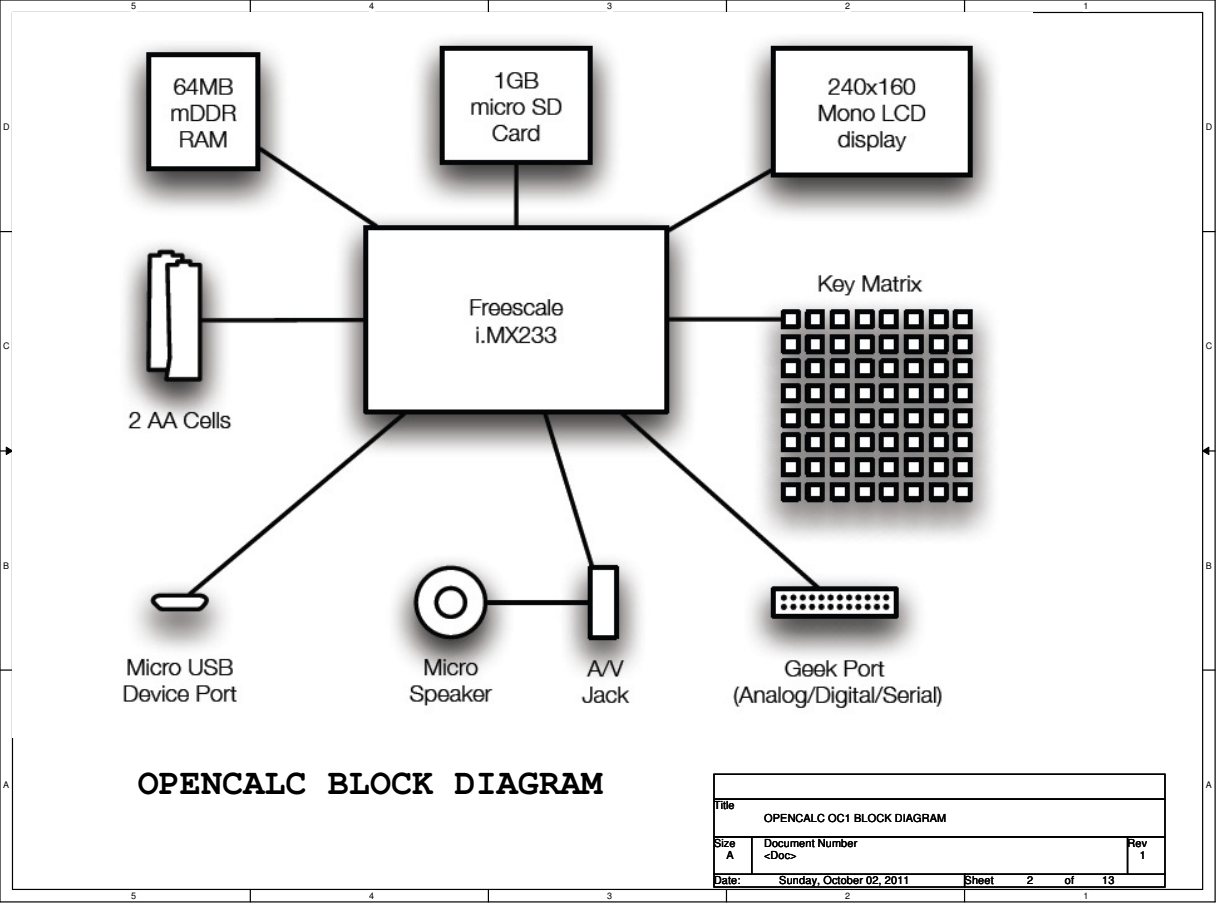
[picture p22: page 2]
Title; Size; Document Number; Rev; Date:; Sheet; <Doc>; Sunday, October 02, 2011

OPENCALC BLOCK DIAGRAM

OPENCALC OC1 BLOCK DIAGRAM

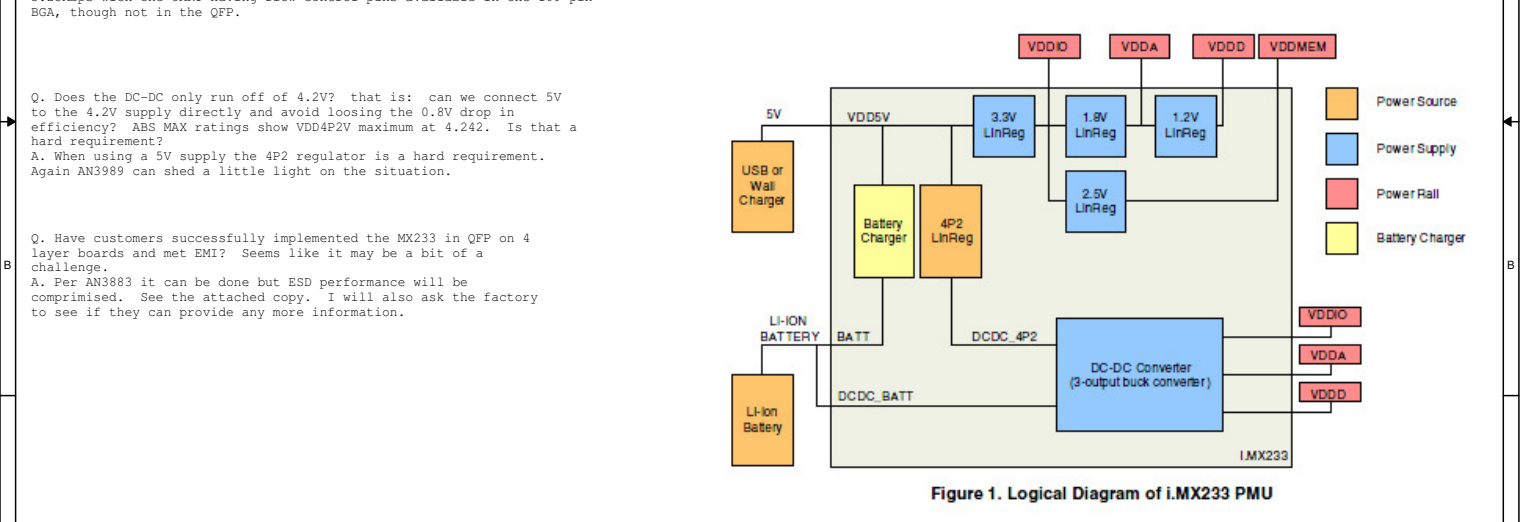
[picture p23: figure]
B B challenge.; BGA, though not in the QFP.; hard requirement?

5

4

3

2

1

C C

A A

# Title

Size | Document Number | Rev
Date: | Sheet | of
| <Doc> | 1

# OPENCALC OC1 DESIGN NOTES

A

Sunday, October 02, 2011 | 3 | 13

# Title

Size | Document Number | Rev
Date: | Sheet | of
| <Doc> | 1

# OPENCALC OC1 DESIGN NOTES

A

Sunday, October 02, 2011 | 3 | 13

# Title

Size | Document Number | Rev
Date: | Sheet | of
| <Doc> | 1

# OPENCALC OC1 DESIGN NOTES

A

Sunday, October 02, 2011 | 3 | 13

# Q. In USB-only power mode is it possible to enumerate at 100mA VBUS current consumption? A. Our team believes this is possible, but is not supported by default in the BSP today. Using mobile DDR would be

recommended to achieve this reliably.

# Questions

# Q. Have customers successfully implemented the MX233 in QFP on 4 layer boards and met EMI? Seems like it may be a bit of a

# A. Per AN3883 it can be done but ESD performance will be

comprimised. | See the attached copy. | I will also ask the factory
to see if they can provide any more information.

# Q. PSWITCH recovery vs. regular USB mode: Is there any difference between the USB boot mode (selected by the boot mode pins) and the recovery mode (selected by the PSWITCH) mode? Is this simply 2 ways of entering the same USB mode?

A. Yes, these are equivalent. | PSWITCH is is just the manual entry into
USB recovery mode. | You can also enter USB recovery mode if there is a
non-recoverable boot time error. | Of course the bootmode switches can land
you here as well.

# Should DQS have pulldowns on board?

# Q. What's the fundamental difference between the application UART and

the debug UART? | Does the debug UART have any special function in the
various boot modes? | Or is it simply a difference in speed it's capable
of?

# A. The debug UART is limited to 115.2Kbps with no flow control pins available in either package. The application UART's are capable of 3.25Mbps with one UART having flow control pins available in the 169 pin

Q. Does the DC-DC only run off of 4.2V? | that is: | can we connect 5V

# to the 4.2V supply directly and avoid loosing the 0.8V drop in

efficiency? | ABS MAX ratings show VDD4P2V maximum at 4.242. | Is that a
A. When using a 5V supply the 4P2 regulator is a hard requirement. Again AN3989 can shed a little light on the situation.

C C

# 6/25/2011: Initial Revision

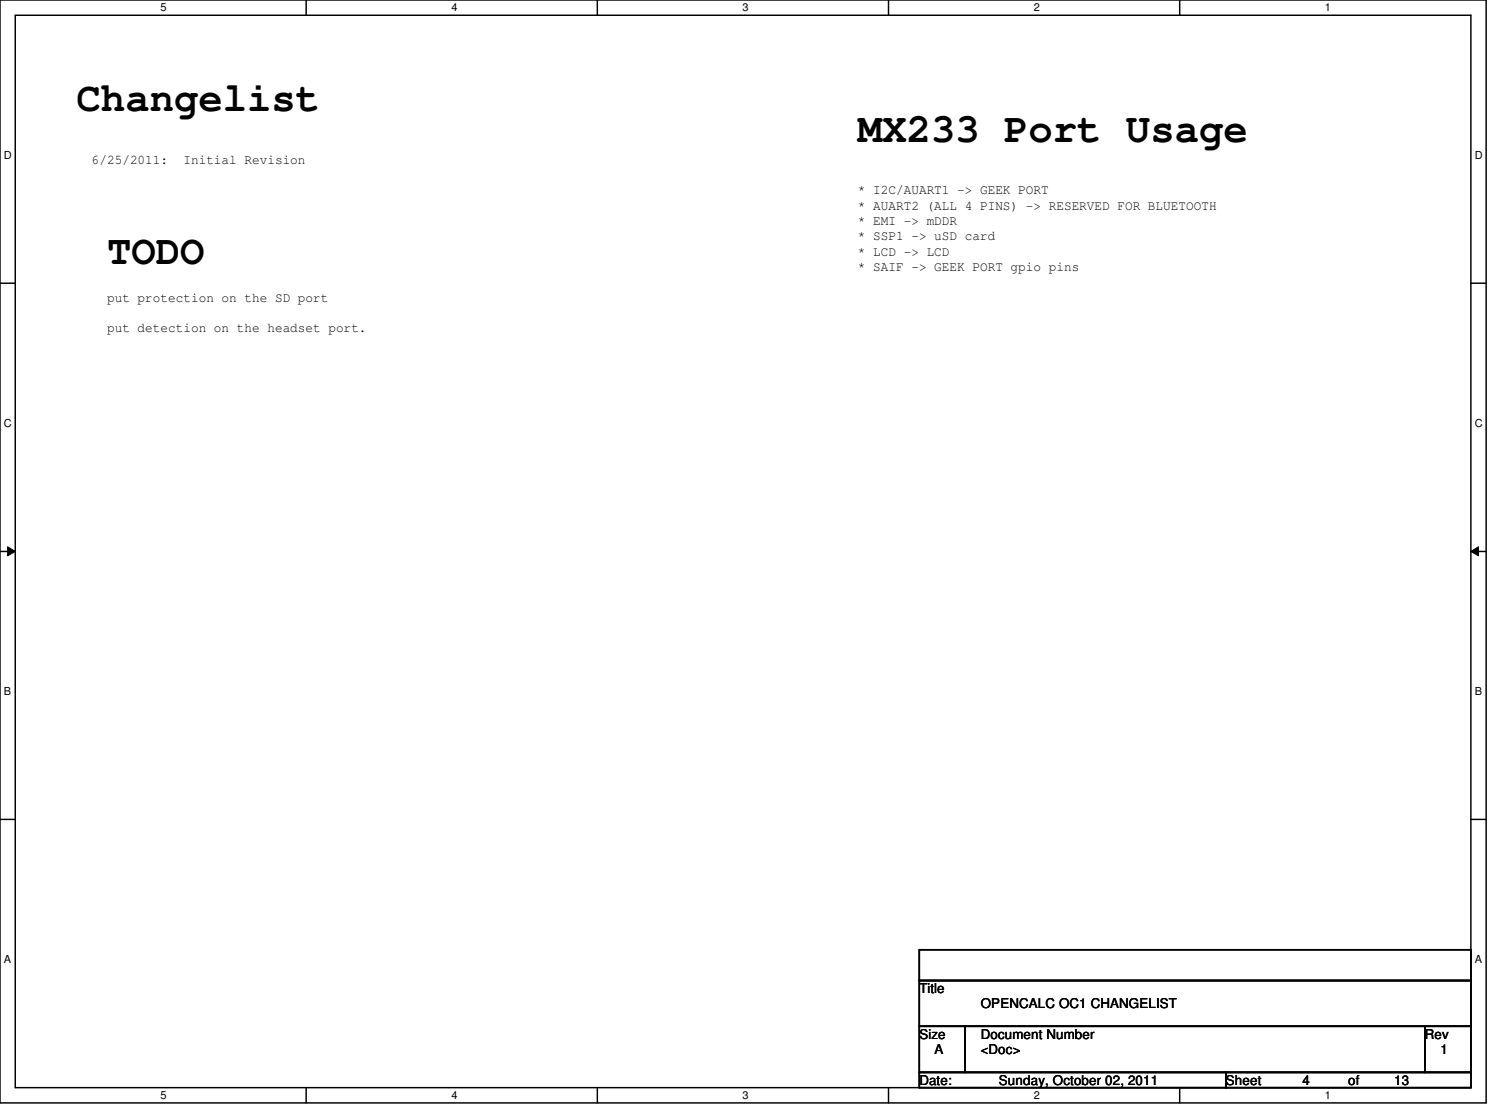
[picture p24: page 4]
Title; Size; Document Number; Rev; Date:; Sheet; <Doc>; OPENCALC OC1 CHANGELIST; Sunday, October 02, 2011; Changelist; MX233 Port Usage; TODO

* I2C/AUART1 -> GEEK PORT
* AUART2 (ALL 4 PINS) -> RESERVED FOR BLUETOOTH
* EMI -> mDDR
* SSP1 -> uSD card
* LCD -> LCD
* SAIF -> GEEK PORT gpio pins

put protection on the SD port

put detection on the headset port.

C C

# USB_DM

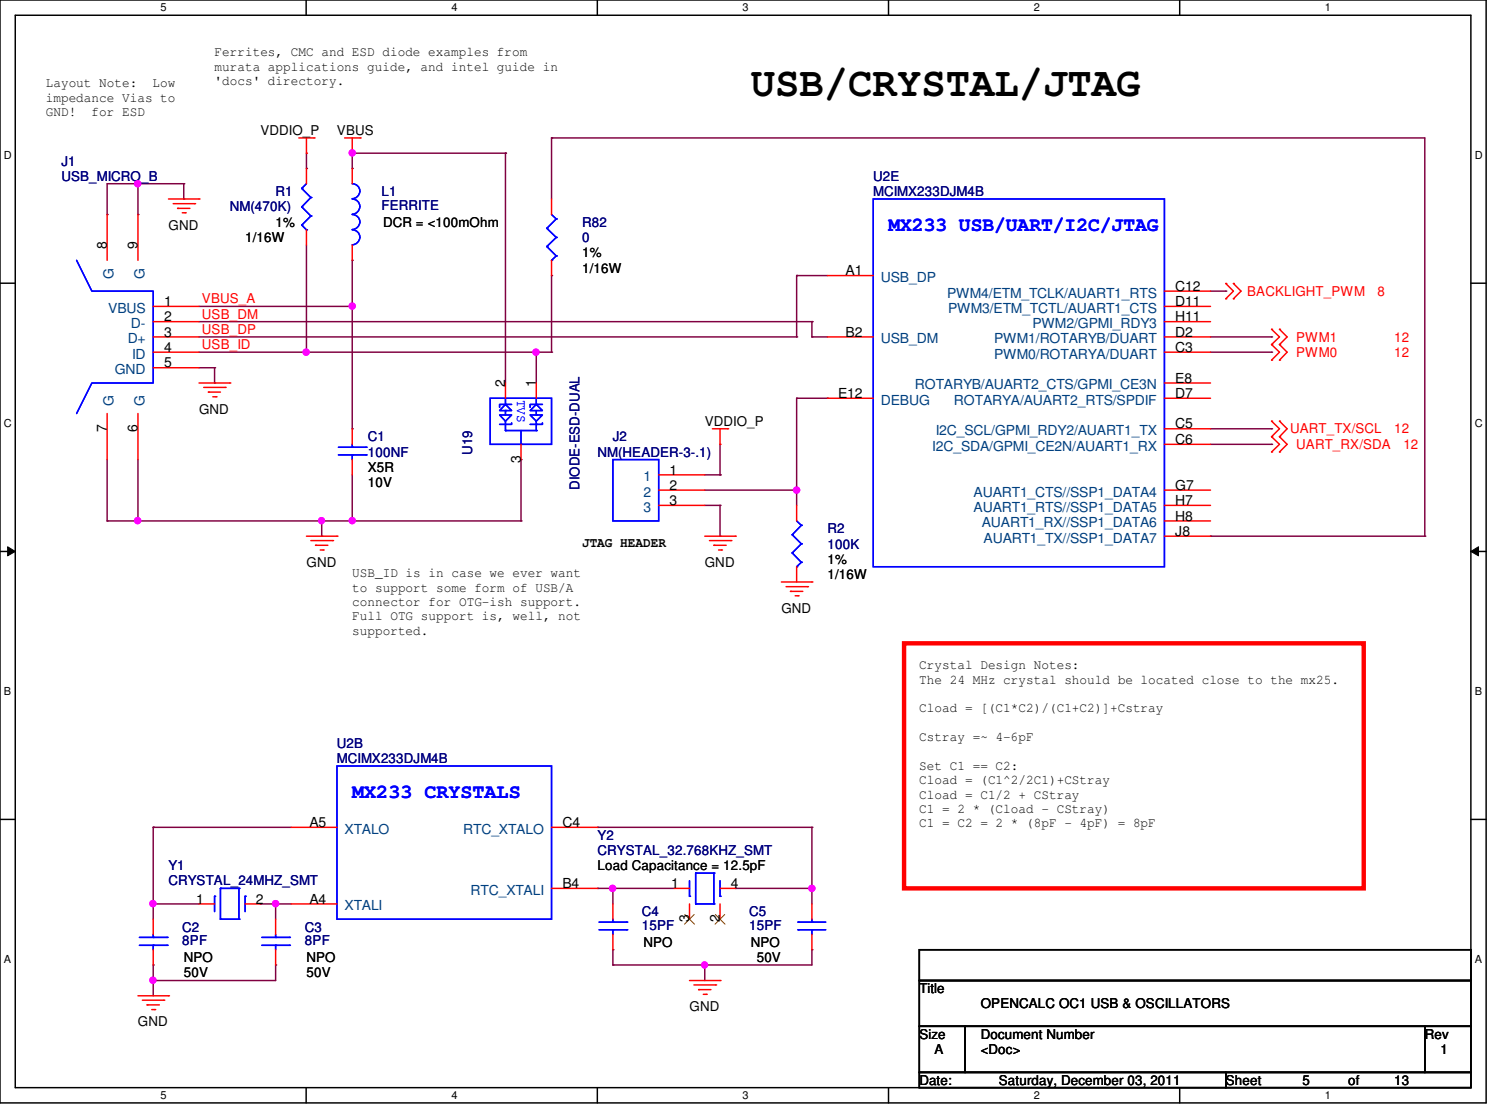
[picture p25: page 5]

Ferrites, CMC and ESD diode examples from
murata applications guide, and intel guide in

USB_ID is in case we ever want
to support some form of USB/A
connector for OTG-ish support.
Full OTG support is, well, not
supported.

Crystal Design Notes:
The 24 MHz crystal should be located close to the mx25.

C C

# DDR_DQS0

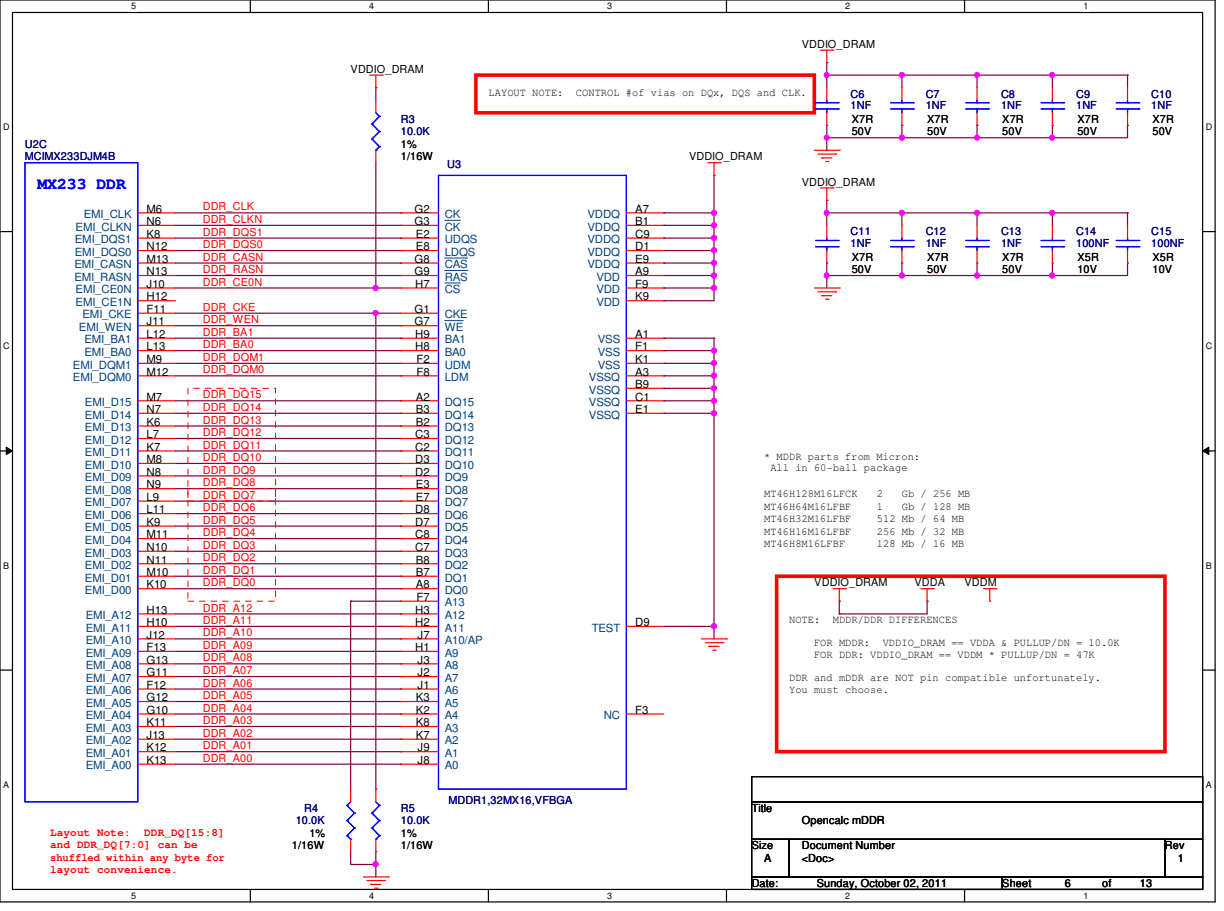
[picture p26: page 6]

* MDDR parts from Micron:
All in 60-ball package

FOR DDR: VDDIO_DRAM == VDDM * PULLUP/DN = 47K

DDR and mDDR are NOT pin compatible unfortunately.
You must choose.

and DDR_DQ[7:0] can be
shuffled within any byte for
layout convenience.

C C

# SD_SCK

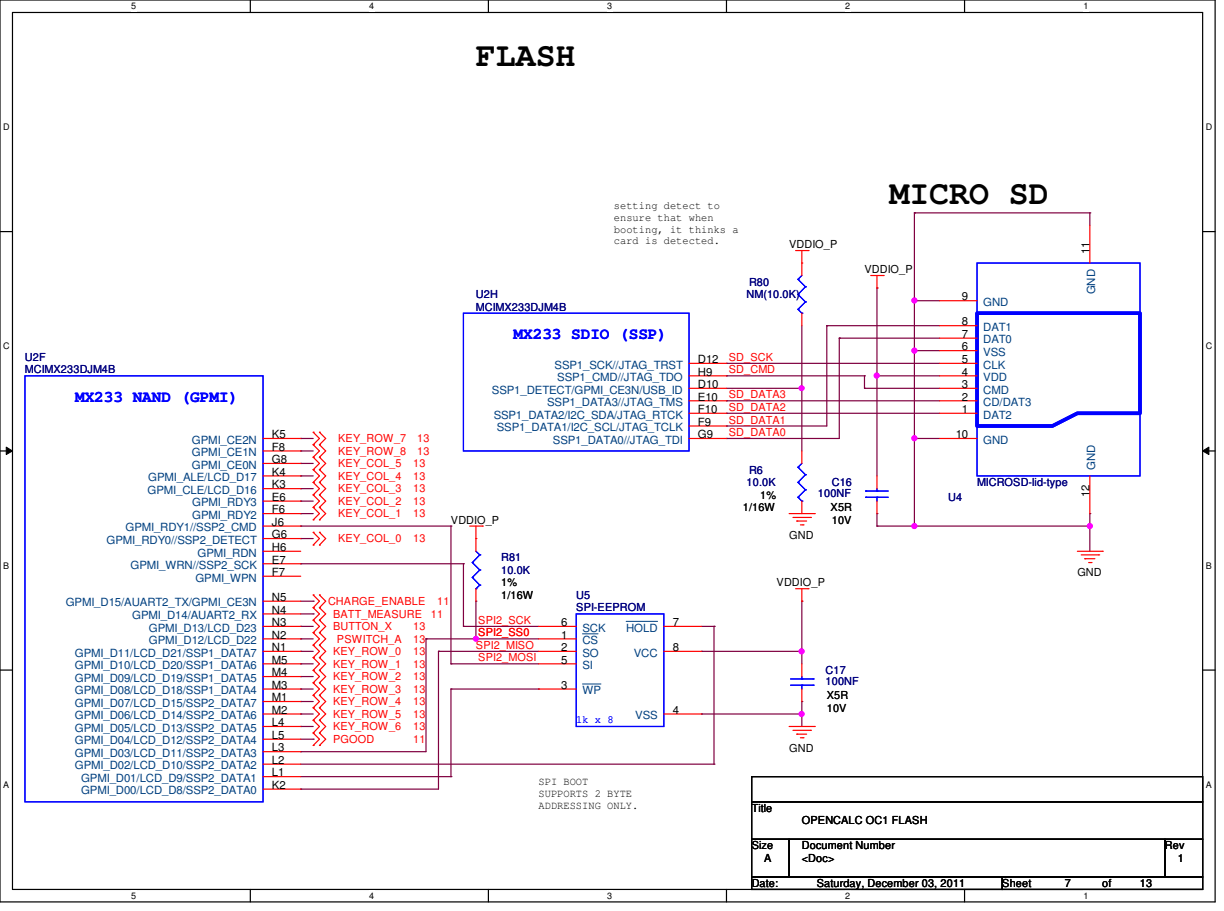
[picture p27: page 7]

# LCD INTERFACE

# TRULY LCD MODULE

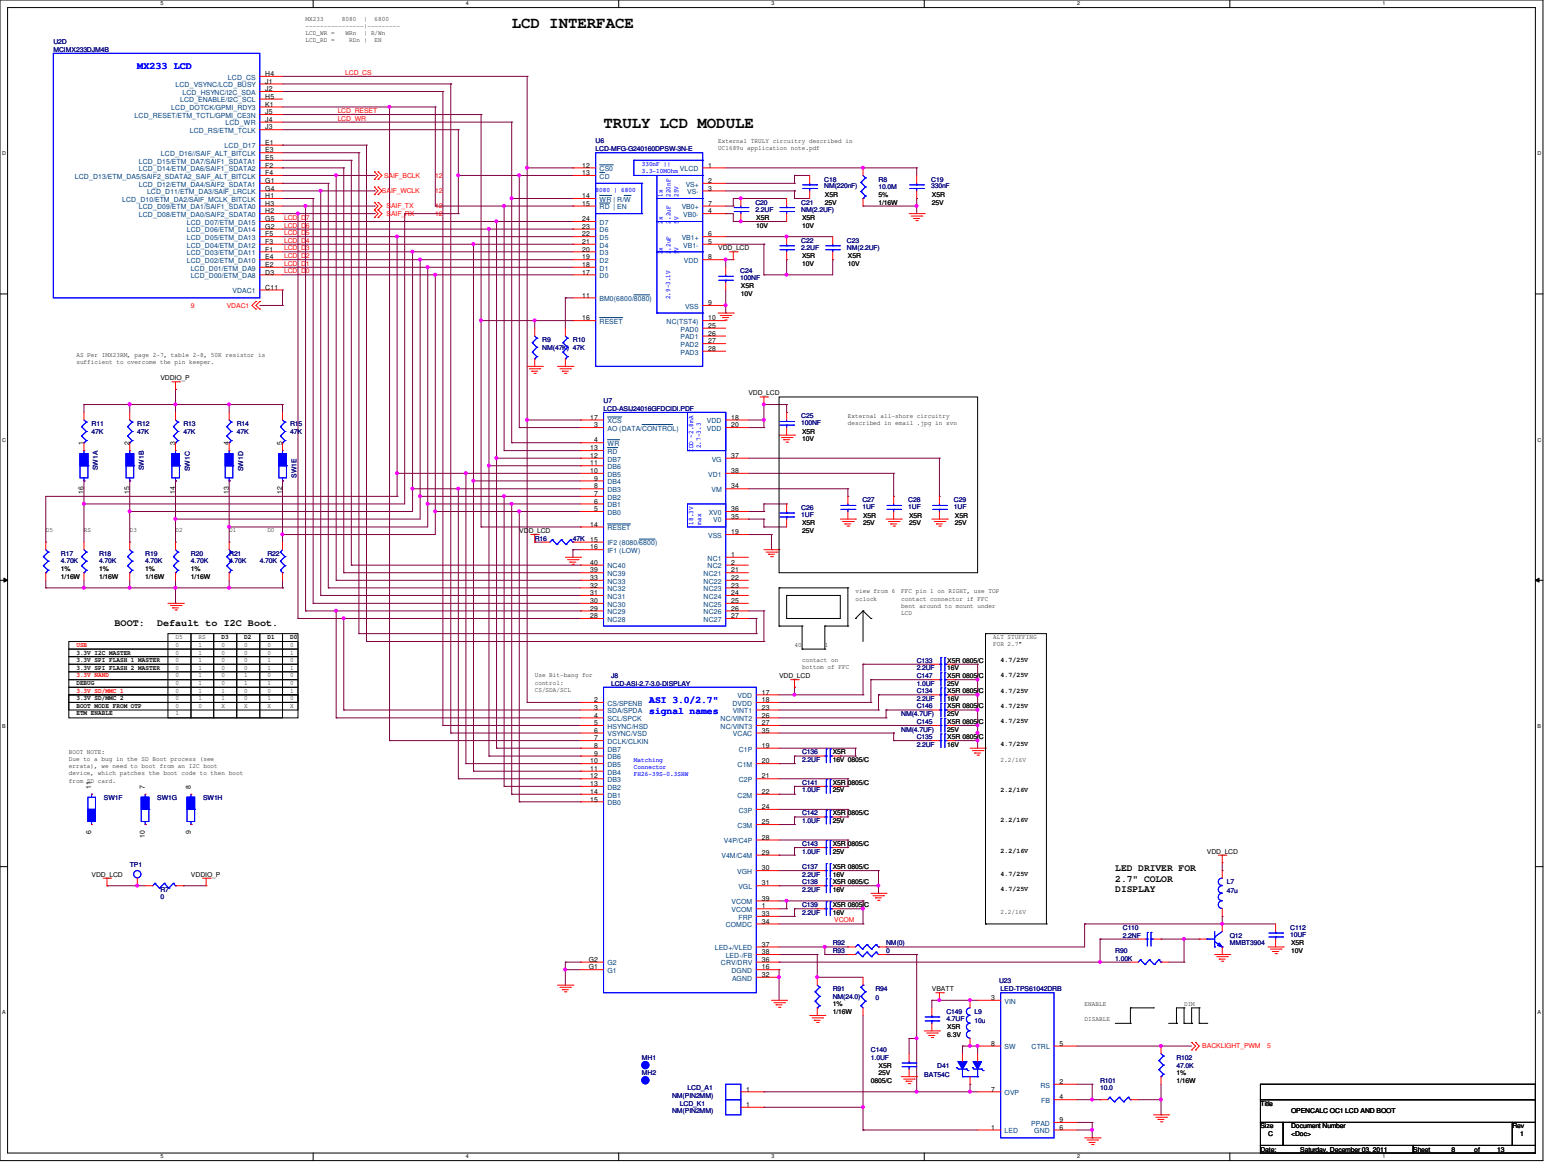
[picture p28: page 8]

External TRULY circuitry described in
UC1689u application note.pdf

AS Per IMX23RM, page 2-7, table 2-8, 50K resistor is
sufficient to overcome the pin keeper.

External all-shore circuitry
described in email .jpg in svn

FFC pin 1 on RIGHT, use TOP
contact connector if FFC
bent around to mount under
LCD

USB
3.3V I2C MASTER
3.3V SPI FLASH 1 MASTER
3.3V SPI FLASH 2 MASTER
3.3V NAND
DEBUG
3.3V SD/MMC 1
3.3V SD/MMC 2
BOOT MODE FROM OTP
ETM ENABLE

Use Bit-bang for
control:
CS/SDA/SCL

BOOT NOTE:
Due to a bug in the SD Boot process (see
errata), we need to boot from an I2C boot
device, which patches the boot code to then boot
from SD card.

OPENCALC OC1 LCD AND BOOT

## GND

## GND

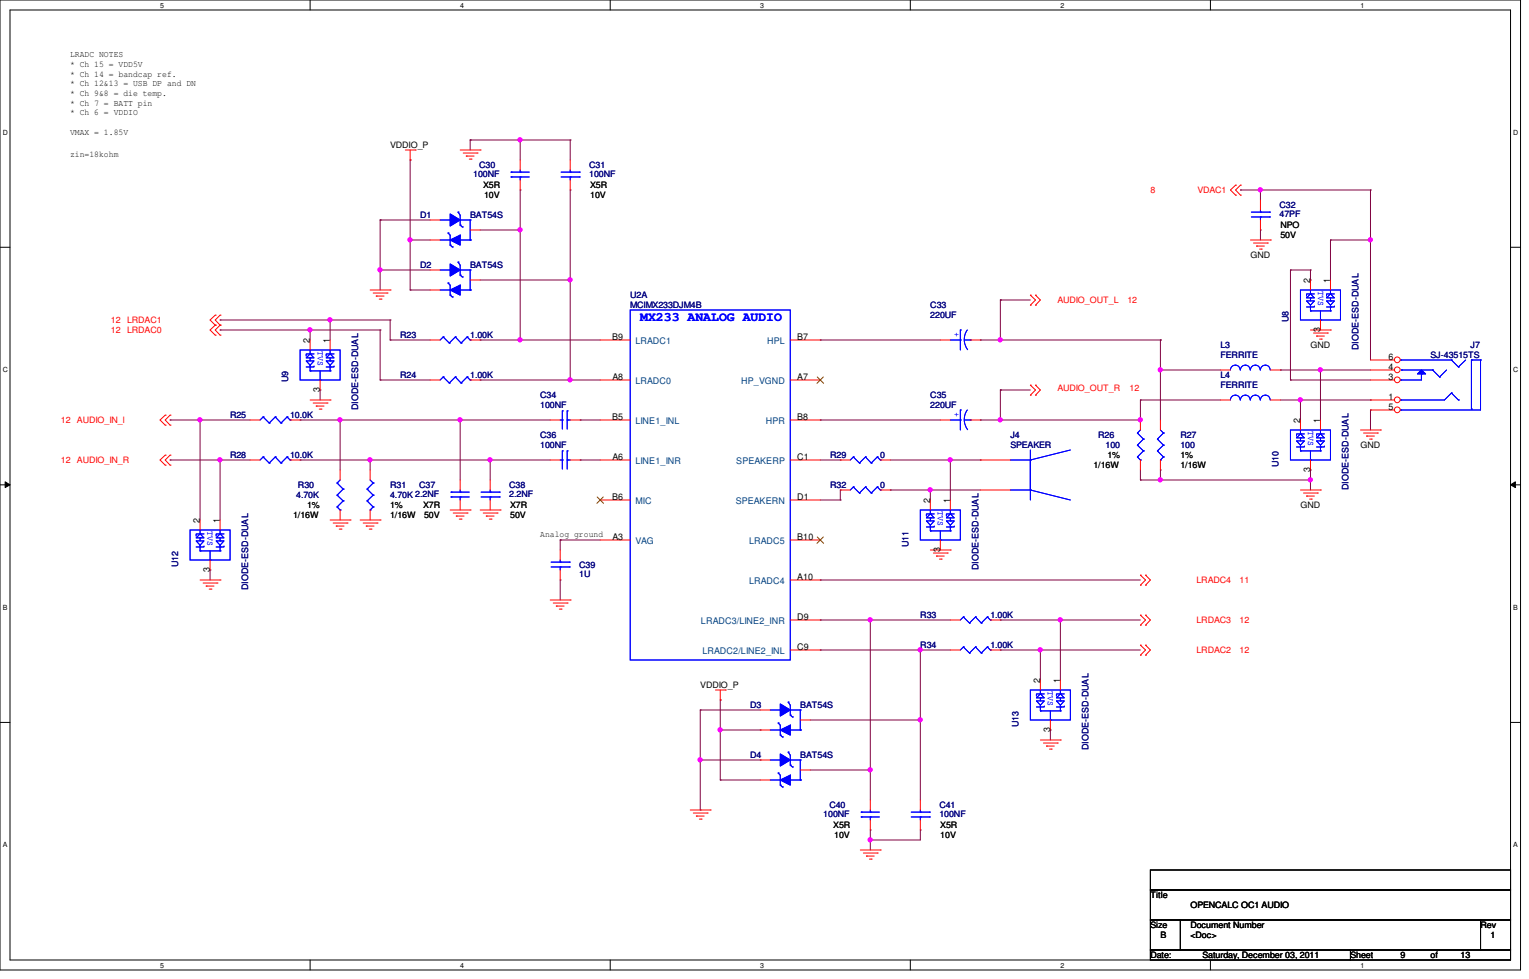
[picture p29: page 9]

LRADC NOTES
* Ch 15 = VDD5V
* Ch 14 = bandcap ref.
* Ch 12&13 = USB DP and DN
* Ch 9&8 = die temp.
* Ch 7 = BATT pin
* Ch 6 = VDDIO

## DCDC_L+

## DCDC_L-

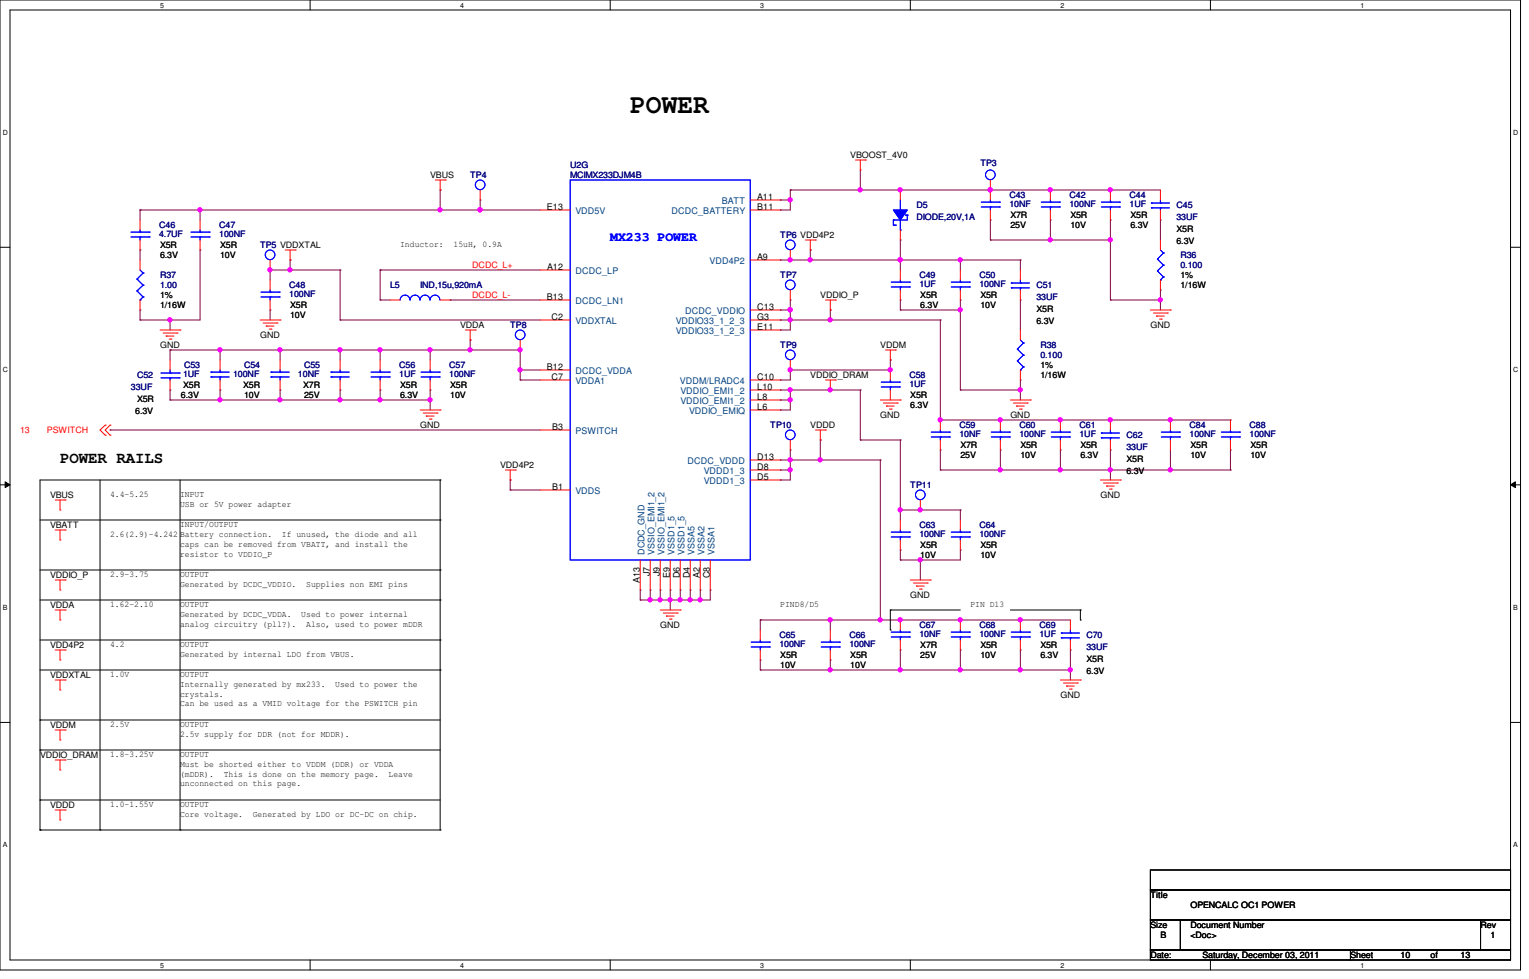
[picture p30: page 10]

VBUS | 4.4-5.25 | INPUT USB or 5V power adapter

VBATT | 2.6(2.9)-4.242 | INPUT/OUTPUT Battery connection. If unused, the diode and all caps can be removed from VBATT, and install the resistor to VDDIO_P

VDDIO_P | 2.9-3.75 | OUTPUT Generated by DCDC_VDDIO. Supplies non EMI pins

VDDA | 1.62-2.10 | OUTPUT Generated by DCDC_VDDA. Used to power internal analog circuitry (pll?). Also, used to power mDDR

VDD4P2 | 4.2 | OUTPUT Generated by internal LDO from VBUS.

VDDXTAL | 1.0V | OUTPUT Internally generated by mx233. Used to power the crystals. Can be used as a VMID voltage for the PSWITCH pin

VDDM | 2.5V | OUTPUT 2.5v supply for DDR (not for MDDR).

VDDIO_DRAM | 1.8-3.25V | OUTPUT Must be shorted either to VDDM (DDR) or VDDA (mDDR). This is done on the memory page. Leave unconnected on this page.

VDDD | 1.0-1.55V | OUTPUT Core voltage. Generated by LDO or DC-DC on chip.

C C

# VBUS

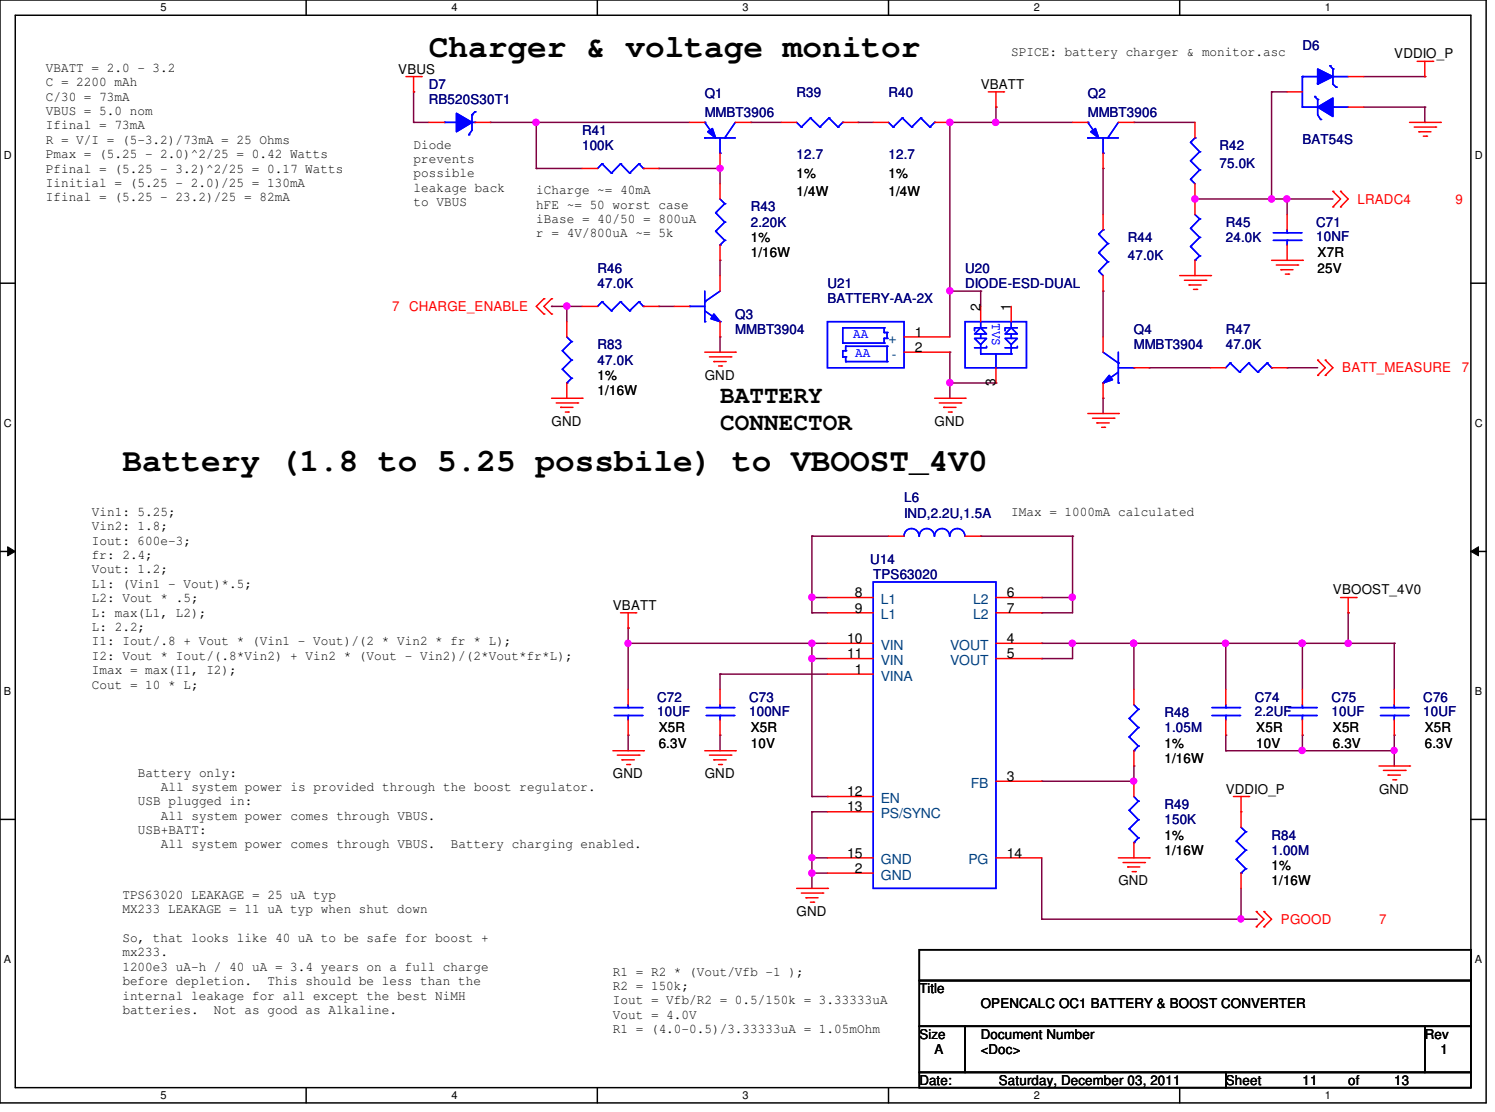
[picture p31: page 11]

Battery (1.8 to 5.25 possbile) to VBOOST_4V0

Battery only:
All system power is provided through the boost regulator.
USB plugged in:
All system power comes through VBUS.
USB+BATT:

TPS63020 LEAKAGE = 25 uA typ
MX233 LEAKAGE = 11 uA typ when shut down

So, that looks like 40 uA to be safe for boost +
1200e3 uA-h / 40 uA = 3.4 years on a full charge
internal leakage for all except the best NiMH

OPENCALC OC1 BATTERY & BOOST CONVERTER

C C

# 9 AUDIO_IN_R

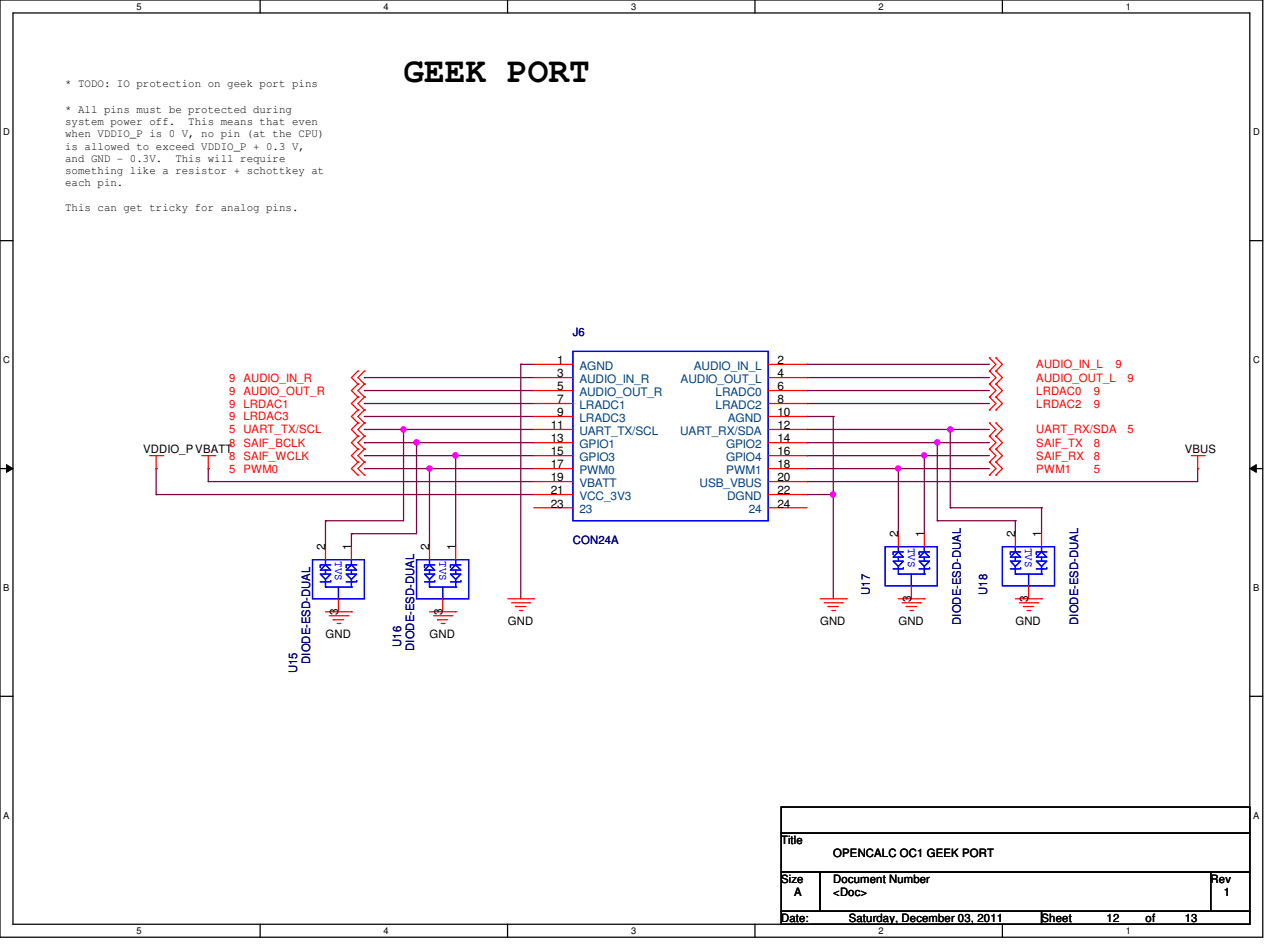
[picture p32: page 12]
GND; VDDIO_P VBATT; VBUS; 9 AUDIO_OUT_R 9 LRDAC1 9 LRDAC3 5 UART_TX/SCL 8 SAIF_BCLK 8 SAIF_WCLK 5 PWM0; AUDIO_IN_L 9 AUDIO_OUT_L 9 LRDAC0 9 LRDAC2 9; UART_RX/SDA 5 SAIF_TX 8 SAIF_RX 8; PWM1; Title; Size; Document Number; Rev; Date:; Sheet; <Doc>; Saturday, December 03, 2011; * TODO: IO protection on geek port pins; GEEK PORT; system power off.; This means that even; and GND - 0.3V.; This will require; TVS; CON24A; AGND 1; AUDIO_IN_L; AUDIO_IN_R 3; AUDIO_OUT_L; AUDIO_OUT_R 5; LRADC0; LRADC1 7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

* All pins must be protected during
when VDDIO_P is 0 V, no pin (at the CPU)
is allowed to exceed VDDIO_P + 0.3 V,
something like a resistor + schottkey at
each pin.

This can get tricky for analog pins.

DIODE-ESD-DUAL

OPENCALC OC1 GEEK PORT

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
VDDIO_P

GND

VDDIO_P

VDDXTAL

GND GND

VDDIO_P

GND

VDDIO_P

GND

GND

GND

GND

VDDIO_P

GND

GND

### 7 KEY_ROW_0

### 7 KEY_ROW_1

### 7 KEY_ROW_2

### 7 KEY_ROW_3

### 7 KEY_ROW_4

### 7 KEY_COL_0

### 7 KEY_COL_1

### 7 KEY_COL_2

### 7 KEY_COL_3

### 7 KEY_COL_4

### 7 KEY_COL_5

### 7 PSWITCH_A

### 10 PSWITCH

### 7 BUTTON_X

### 7 KEY_ROW_5

### 7 KEY_ROW_6

### 7 KEY_ROW_7

### 7 KEY_ROW_8

Title

Size | Document Number | Rev
Date: | Sheet | of
<Doc> | 1

OPENCALC OC1 KEYPAD MATRIX

C

Saturday, December 03, 2011 | 13 | 13

Title

Size | Document Number | Rev
Date: | Sheet | of
<Doc> | 1

OPENCALC OC1 KEYPAD MATRIX

C

Saturday, December 03, 2011 | 13 | 13

Title

Size | Document Number | Rev
Date: | Sheet | of
<Doc> | 1

OPENCALC OC1 KEYPAD MATRIX

C

Saturday, December 03, 2011 | 13 | 13

# KEYPAD MATRIX

No ESD protection required if keymat can be made without locating holes. Is it possible to make the keymat holes just indentations?

Keyscan Technique:

Software must drive rows low, and set col lines to input, interrupt whenever a colum line goes low. (or poll, that's fine too)

Then, when a column line goes low, to determine which key has been pressed, in the ISR sequence through each row with one-row-high and see which col line toggles.

Any col lines that go high is pressed. The diodes prevent shorting 2 row and 2 col lines directly.

NOTE: PSWITCH must have a
falling edge SLOWER than
15nS to prevent power off
when PSWITCH pressed.

NOTE; These caps are to keep the contacts clean, not to do any debouncing.

## RECOVERY

POWER_SW

SHIFT_SW

PRESS BOTH SW67 AND SW68 TO ENTER RECOVERY MODE.

PSWITCH_A is not strictly necessary -- the PSWITCH pin state can be polled from software. But this lets is operate simply from an interrupt.

10K
SPECIFIED IN
DATASHEET

PSWITCH STATES:
* If PSWITCH > min (MID) for > 100mS, then power on
* If PSWITCH has a falling edge faster than 15nS, power OFF
* If PSWITCH > min(MID), lower bit of HW_POWER_STS_PSWITCH is set.
* if PSWITCH is pulled to VDDIO via a resistor, upper bit of HW_POWER_STS_PSWITCH is set. * if PSWITCH is pulled to VDDIO during initial boot sequence for more than 5 seconds, FW recovery mode is entered.
LOW: | 0 < PSWITCH < 0.30
MID: | 0.65 < PSWITCH < 1.5
HIGH: 2.1 < PSWITCH < VDDXTAL+1.575 = 2.575

VDDXTAL: ~ 1V
VDDIO: ~3.3

D14

SW51
NM(SW-PUCK)

TP14

Q5
MMBT3904

SW44
NM(SW-PUCK)

D9

R69
10.0K
1%
1/16W

SW57
NM(SW-PUCK)

R68
1.00K
R79 | 100K

Q6
MMBT3906

D8

SW56
NM(SW-PUCK)

C79

1NF

Q8
MMBT3904

SW50
NM(SW-PUCK)

D24
RB520S30T1

SW55
NM(SW-PUCK)

R62 4.70K

SW5
NM(SW-PUCK)

D34

SW54
NM(SW-PUCK)

R58 4.70K

D37

R54

1.00K

D22

SW4
NM(SW-PUCK)

Q9
MMBT3904

C78

1NF

R75
1.00K

D17

SW3
NM(SW-PUCK)

R71
10.0K

D31

SW53
NM(SW-PUCK)

R51

1.00K

D16

R61 4.70K

SW8
NM(SW-PUCK)

SW2
NM(SW-PUCK)

TP12

D39

C77

1NF

SW20
NM(SW-PUCK)

SW52
NM(SW-PUCK)

R70
10.0K

C80

1NF

SW9
NM(SW-PUCK)

SW25
NM(SW-PUCK)

D26

R50

1.00K

C87
1NF

C81

1NF

SW41
NM(SW-PUCK)

R73
100K

SW24
NM(SW-PUCK)

D25

D13

SW40
NM(SW-PUCK)

SW16
NM(SW-PUCK)

SW23
NM(SW-PUCK)

D12

R55

1.00K

R60 4.70K

TP13

SW22
NM(SW-PUCK)

Q7
MMBT3904

C85
1NF

SW39
NM(SW-PUCK)

SW15
NM(SW-PUCK)

R52

1.00K

D21

R66
47.0K

SW38
NM(SW-PUCK) | R76
| 10.0K

SW14
NM(SW-PUCK)

D10

C86
10NF
X7R
25V

SW19
NM(SW-PUCK)

D20

R59 4.70K

SW63
NM(SW-PUCK)

D30

SW37
NM(SW-PUCK)

SW13
NM(SW-PUCK)

SW33
NM(SW-PUCK)

SW49
NM(SW-PUCK)

R72
100K

SW62
NM(SW-PUCK)

D32

D33

D29

C82

1NF

SW36
NM(SW-PUCK)

SW12
NM(SW-PUCK)

SW32
NM(SW-PUCK)

SW61
NM(SW-PUCK)

D40

SW11
NM(SW-PUCK)

SW31
NM(SW-PUCK)

SW67
NM(SW-PUCK)

SW48
NM(SW-PUCK)

SW30
NM(SW-PUCK)

SW66
NM(SW-PUCK)

SW47
NM(SW-PUCK)

D18

R78
47.0K

SW60
NM(SW-PUCK)

R74
1.00K

SW29
NM(SW-PUCK)

R53

1.00K

SW65
NM(SW-PUCK)

SW27
NM(SW-PUCK)

SW46
NM(SW-PUCK)

R77
10.0K

D36

SW59
NM(SW-PUCK)

D38

R63 4.70K

D27

SW64
NM(SW-PUCK)

SW45
NM(SW-PUCK)

D35

R67
100K

SW28
NM(SW-PUCK)
