blackketter/oc1/pa1/docs/bluetooth/csr bc6-rom/BlueCore6-ROM QFN Example Design (RED-PC-115B).pdf

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

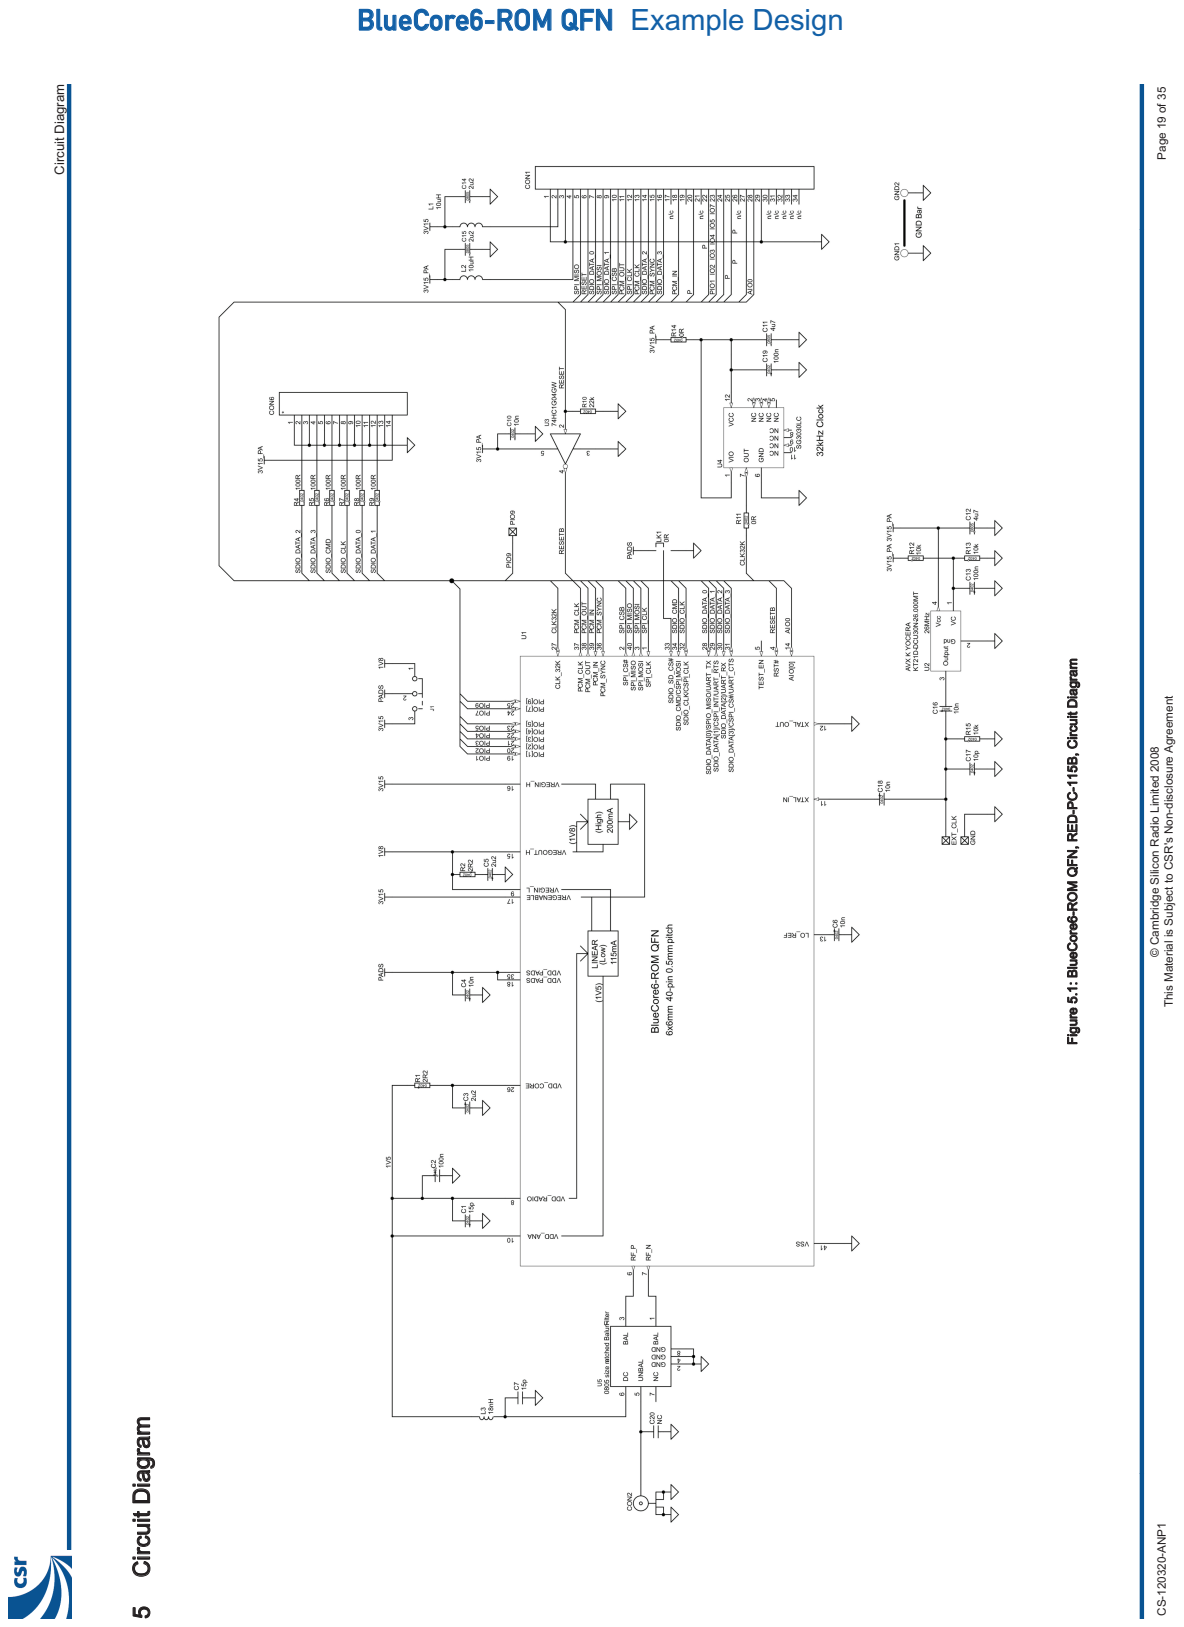
[picture p33: page 1]
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
