blackketter/oc1/pa1/docs/mx233/switches/ENG_CD_1825910_C6.pdf

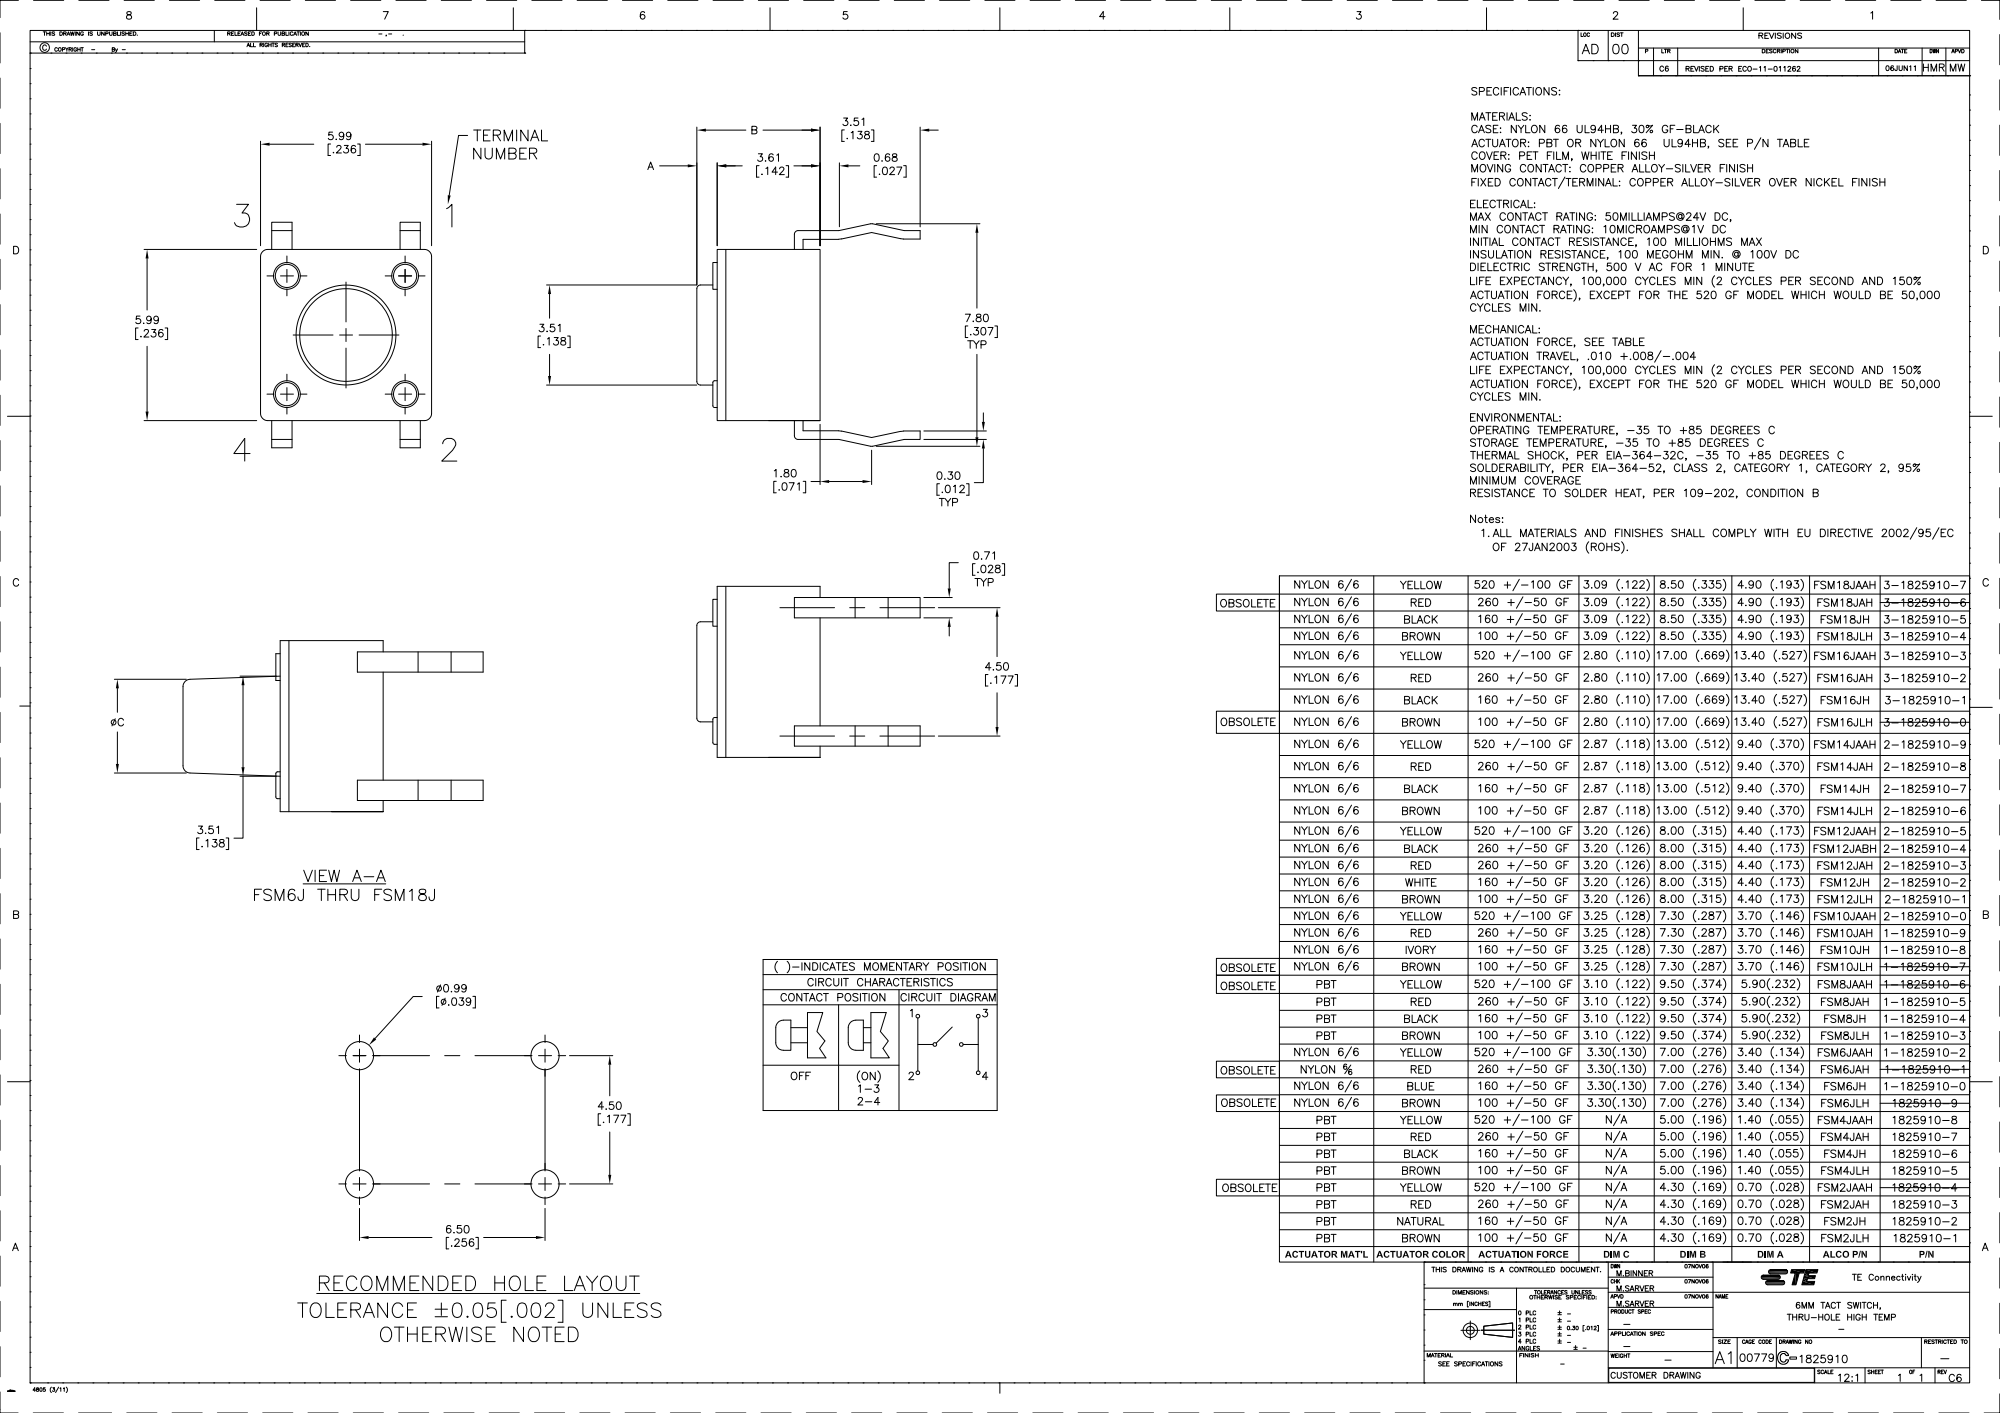
[picture p34: page 1]
