blackketter/oc1/pa1/simulation/battery charger and monitor.asc

C1: cap; 10n
D1: schottky; BAT54
Q1: pnp; 2N3906
Q2: npn; 2N3904
Q3: pnp; 2N3906
Q4: npn; 2N3904
R1: res; 100k
R2: res; 2.2k
R3: res; 47k
R4: res; 12.7
R5: res; 12.7
R6: res; 47k
R7: res; 75k
R8: res; 24k
R9: res; 100k
V1: voltage; 3
V2: voltage; 5
V3: voltage; PWL(0 0 1m 0 2m 3.0)
V4: voltage; PWL(0 0 5m 3 100m 3.0)
Named nets: 0, LRADC4, BATT_MEASURE, VBATT, VBUS, CHARGE_ENABLE
.tran 20m
