blackketter/oc1/pa1/simulation/LED driver simulation, 0.1V dropout.asc

C1: cap; 10n
C2: cap; 1n
D1: LED; NSSWS108T
M1: pmos; FDS4559_P
M2: pmos; FDS4559_P
R1: res; 1
R2: res; 18k
R3: res; 2k
R5: res; 100
U1: opamp
U2: opamp
V1: voltage; 4.44
V2: voltage; .7
V3: voltage; PULSE(20 -20 0 1p 1p 10u 20u 10)
Named nets: 0
.lib opamp.sub
.tran .05m
