blackketter/oc1/pa1/simulation/power switch and recovery mode pswitch.asc

C1: cap; 10n
D1: schottky; BAT54
M1: pmos; BSS84
M2: pmos; BSS84
Q1: npn; 2N3904
Q2: npn; 2N3904
Q3: npn; 2N3904
Q4: pnp; 2N3906
Q5: npn; 2N3904
R1: res; 47k
R2: res; 100k
R3: res; 10k
R4: res; 10k
R5: res; 10k
R6: res; 1k
R7: res; 47k
R8: res; 100k
R9: res; 100k
R10: res; 100k
R11: res; 10k
R12: res; 10k
V1: voltage; PWL(0 0 5m 3.3)
V2: voltage; 1.2
V3: voltage; PWL(0 10 15m 10 15.01m -10 30m -10 30.1m 10)
V4: voltage; PWL(0 10 10m 10 10.1m -10 20m -10 20.1m 10)
Named nets: 0, pswitch, vddio_p, pswitch_a, button_x, vdd_xtal, b1, b2
.tran 100m
