blackketter/oc1/pa1/simulation/simple LED driver.  Duh.asc

C1: cap; 1p
D1: LED; LXHL-BW02
R1: res; 100k
R2: res; 3.0k
R3: res; 1.3
R4: res; 100K
R5: res; 200
U1: opamp
V1: voltage; PULSE(0 3.0 0 1p 1p 50u 100u 1000); AC 1
V2: voltage; 4
Named nets: 0
.lib opamp.sub
.tran 1m
;ac oct 100 1 100e6
