blackketter/oc1/(list of files, drawings)

Other design files:
pa1/docs/mx233/IMX23REFSCH/I.MX23_REFERENCE_SCH_REVB.DSN
pa1/pcb/opencalc-autoroute.pcb
pa1/pcb/opencalc.pcb
pa1/pcb/opencalc_cpumodule.pcb
pa1/sch/OPENCALC-PA1.DSN
pa1/sch/OPENCALC-PA1.opj
