blackketter/oc1/(commit log)

2011-09-05 First check-in of OC1 hardware design
    [IMX23_POWER_CONSUMP_CALC.xls]
2011-09-28 Resetting author. The latest oc1 schematic.
    [OPENCALC-PA1.BOM.csv, OPENCALC-PA1.DSN, OPENCALC-PA1.opj]
2011-11-20 removed PA1. Will add back current rev and start working from this directory instead of SVN
    [OPENCALC-PA1.BOM.csv, OPENCALC-PA1.DSN, OPENCALC-PA1.opj]
2011-11-20 Added PA1 stuff from svn
    [I.MX23_REFERENCE_SCH_REVB.DSN, OPENCALC-CPU-PA1.DSN, OPENCALC-CPU-PA1.opj, OPENCALC-PA1.BOM.csv, OPENCALC-PA1.DSN, OPENCALC-PA1.opj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]
2011-11-20 fix for new base directory
    [OPENCALC-PA1.opj]
2012-01-09 Updated pcb. It's pretty close to something that can be fabbed now.
    [OPENCALC-CPU-PA1.DSN, OPENCALC-CPU-PA1.opj]
2012-01-09 It seems that PADS is not great at rounding positions of vias -- the pad of a via ends up at a different location from the drill! Crazy. This causes errors in the CAM output. find_offgrid.py finds th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
    Similarly, plot_protoexpress.py creates a .dxf file based on errors
    from the protoexpress freedfm report.
2012-01-24 Layout pretty much ready to go
    [OPENCALC-PA1.DSN, OPENCALC-PA1.opj, opencalc.pcb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]
